jspolsky/blinky/blinky (esp32-idf)/README.md

# blinky by Joel

The code that runs the 2022 burning man BLINKY gift.

Intended for ESP32-C3 chips, using native Espressif stuff (IDF) without any Arduino code.

Best run/built/edited using VS Code.
