jspolsky/blinky/pcbs/turtleEdge/Bitmap All Outline Only.png

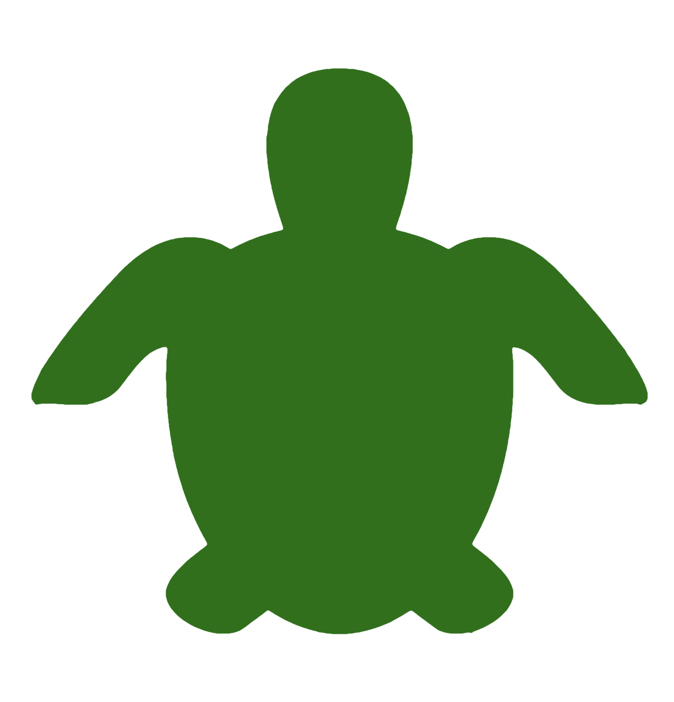
pcbs/turtleEdge/Bitmap All Outline Only.png
