jspolsky/blinky/pcbs/turtleEdge/Bitmap All.pxd/QuickLook/Thumbnail.tiff

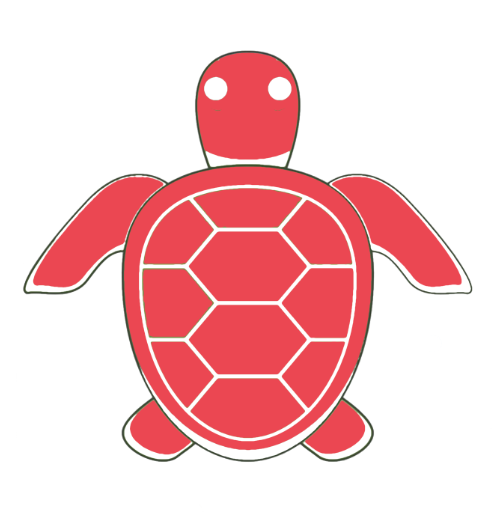
pcbs/turtleEdge/Bitmap All.pxd/QuickLook/Thumbnail.tiff
