jspolsky/blinky/pcbs/turtleEdge/OriginalScreenShot.png

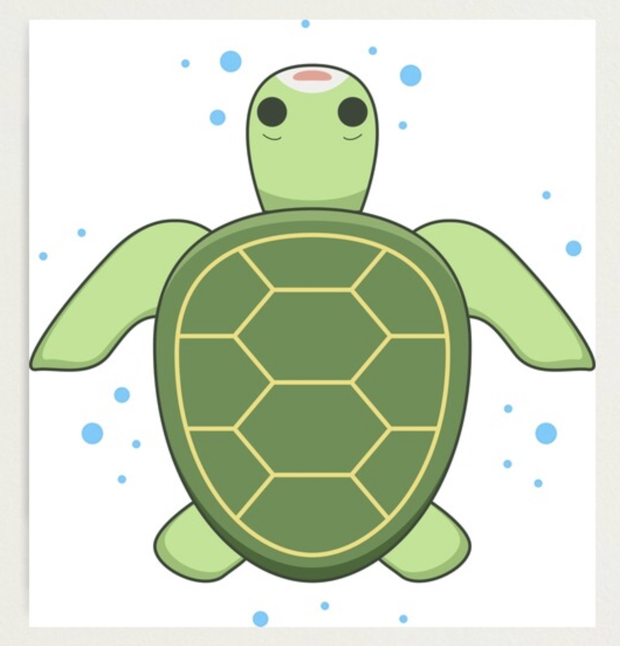
pcbs/turtleEdge/OriginalScreenShot.png
