jspolsky/blinky/pcbs/ledtrix/ledtrix_gerber_01/bom.xlsx

Comment | Designator | Footprint | LCSC Part Number
White 0603 Light Emitting Diodes (LED) RoHS | D1.1, D1.2, D1.3, D1.4, D1.5, D1.6, D1.7, D1.8, D1.9, D1.10, D1.11, D1.12, D1.13, D1.14, D1.15, D1.16 | 0603 | C2290
White 0603 Light Emitting Diodes (LED) RoHS | D2.1, D2.2, D2.3, D2.4, D2.5, D2.6, D2.7, D2.8, D2.9, D2.10, D2.11, D2.12, D2.13, D2.14, D2.15, D2.16 | 0603 | C2290
White 0603 Light Emitting Diodes (LED) RoHS | D3.1, D3.2, D3.3, D3.4, D3.5, D3.6, D3.7, D3.8, D3.9, D3.10, D3.11, D3.12, D3.13, D3.14, D3.15, D3.16 | 0603 | C2290
White 0603 Light Emitting Diodes (LED) RoHS | D4.1, D4.2, D4.3, D4.4, D4.5, D4.6, D4.7, D4.8, D4.9, D4.10, D4.11, D4.12, D4.13, D4.14, D4.15, D4.16 | 0603 | C2290
White 0603 Light Emitting Diodes (LED) RoHS | D5.1, D5.2, D5.3, D5.4, D5.5, D5.6, D5.7, D5.8, D5.9, D5.10, D5.11, D5.12, D5.13, D5.14, D5.15, D5.16 | 0603 | C2290
White 0603 Light Emitting Diodes (LED) RoHS | D6.1, D6.2, D6.3, D6.4, D6.5, D6.6, D6.7, D6.8, D6.9, D6.10, D6.11, D6.12, D6.13, D6.14, D6.15, D6.16 | 0603 | C2290
White 0603 Light Emitting Diodes (LED) RoHS | D7.1, D7.2, D7.3, D7.4, D7.5, D7.6, D7.7, D7.8, D7.9, D7.10, D7.11, D7.12, D7.13, D7.14, D7.15, D7.16 | 0603 | C2290
White 0603 Light Emitting Diodes (LED) RoHS | D8.1, D8.2, D8.3, D8.4, D8.5, D8.6, D8.7, D8.8, D8.9, D8.10, D8.11, D8.12, D8.13, D8.14, D8.15, D8.16 | 0603 | C2290
White 0603 Light Emitting Diodes (LED) RoHS | D9.1, D9.2, D9.3, D9.4, D9.5, D9.6, D9.7, D9.8, D9.9, D9.10, D9.11, D9.12, D9.13, D9.14, D9.15, D9.16 | 0603 | C2290
