jspolsky/blinky/pcbs/turtleEdge/R14_Outline.dxf

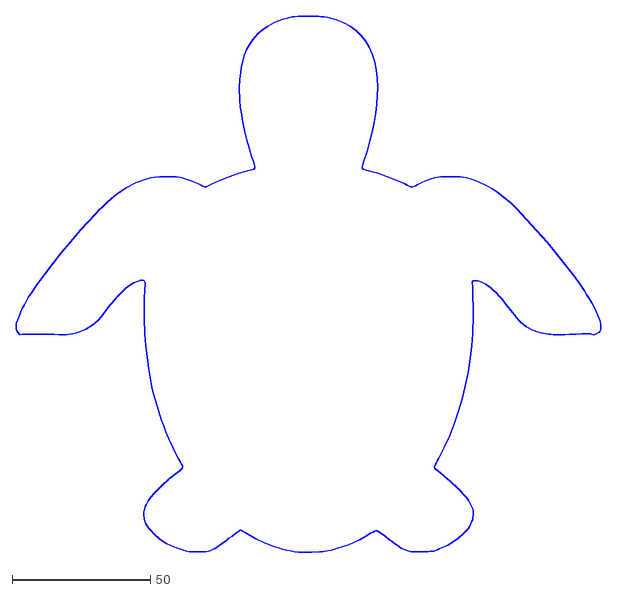
[picture p4: CAD file, 2021-12-18]
pcbs/turtleEdge/R14_Outline.dxf
211.7 x 194.2
