jspolsky/blinky/pcbShape/piece1.dxf

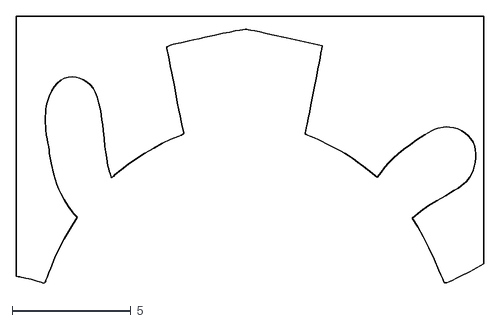
[picture p5: CAD file, 2021-12-30]
pcbShape/piece1.dxf
19.7 x 11.3
