jspolsky/blinky/pcbShape/piece1-4.dxf

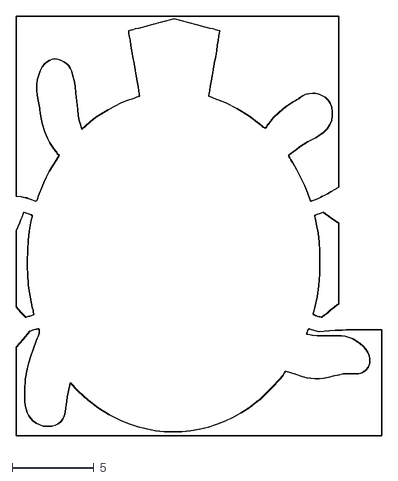
[picture p6: CAD file, 2021-12-30]
pcbShape/piece1-4.dxf
22.4 x 26.0
