jspolsky/blinky/pcbShape/experiment.dxf

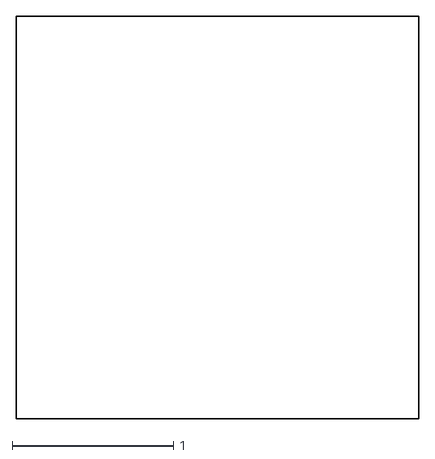
[picture p7: CAD file, 2021-12-30]
pcbShape/experiment.dxf
2.50 x 2.50
