jspolsky/blinky/pcbShape/turtle.dxf

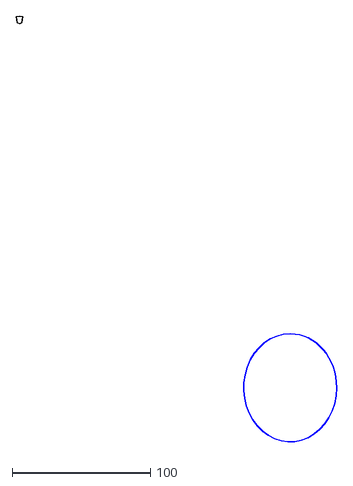
[picture p8: CAD file, 2021-12-30]
pcbShape/turtle.dxf
232.1 x 311.4
