jspolsky/blinky/pcbs/blinky/blinky.kicad_pcb

## KiCad design pcbs/blinky/blinky.kicad_pcb (2022-02-21)

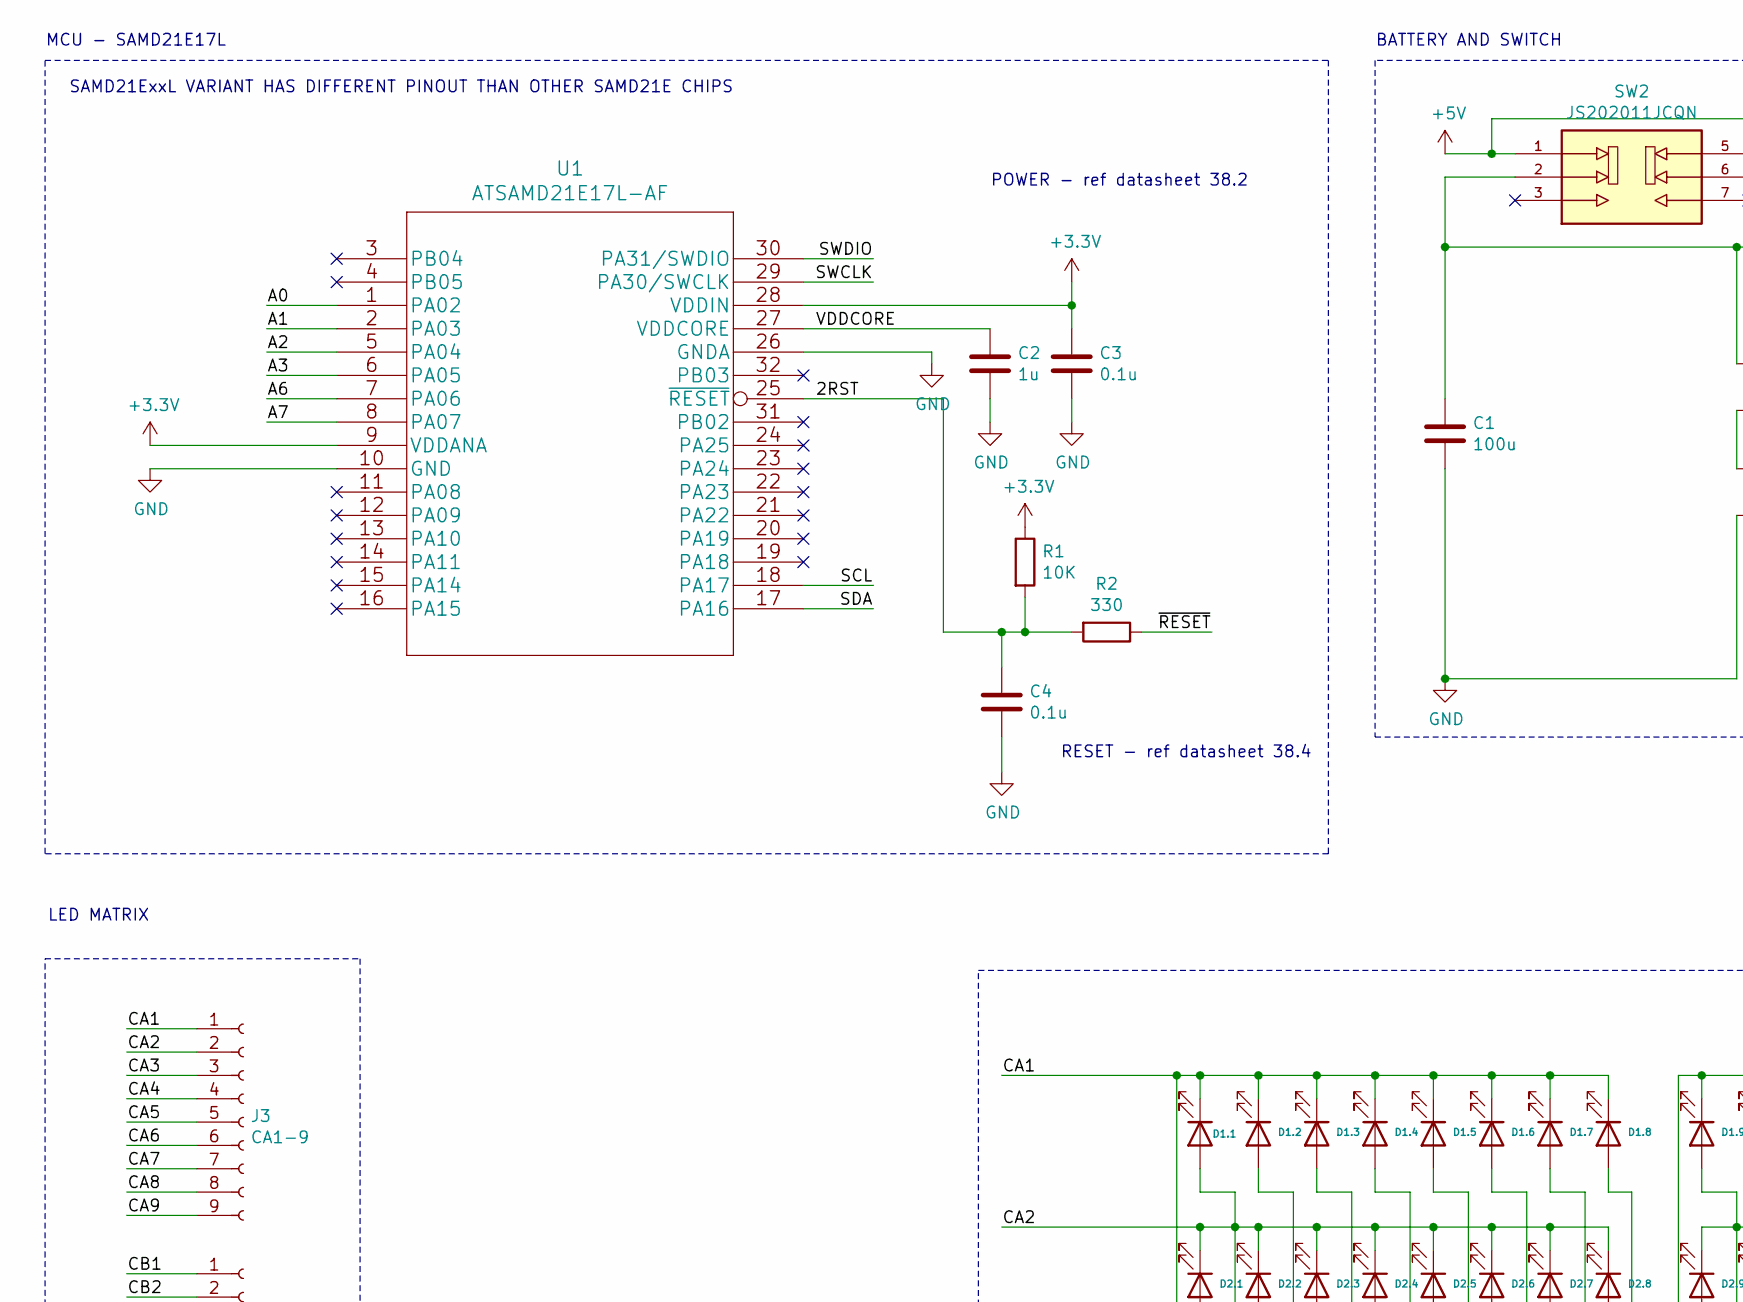
[picture p9: schematic blinky.sch, part in row 1, column 1]

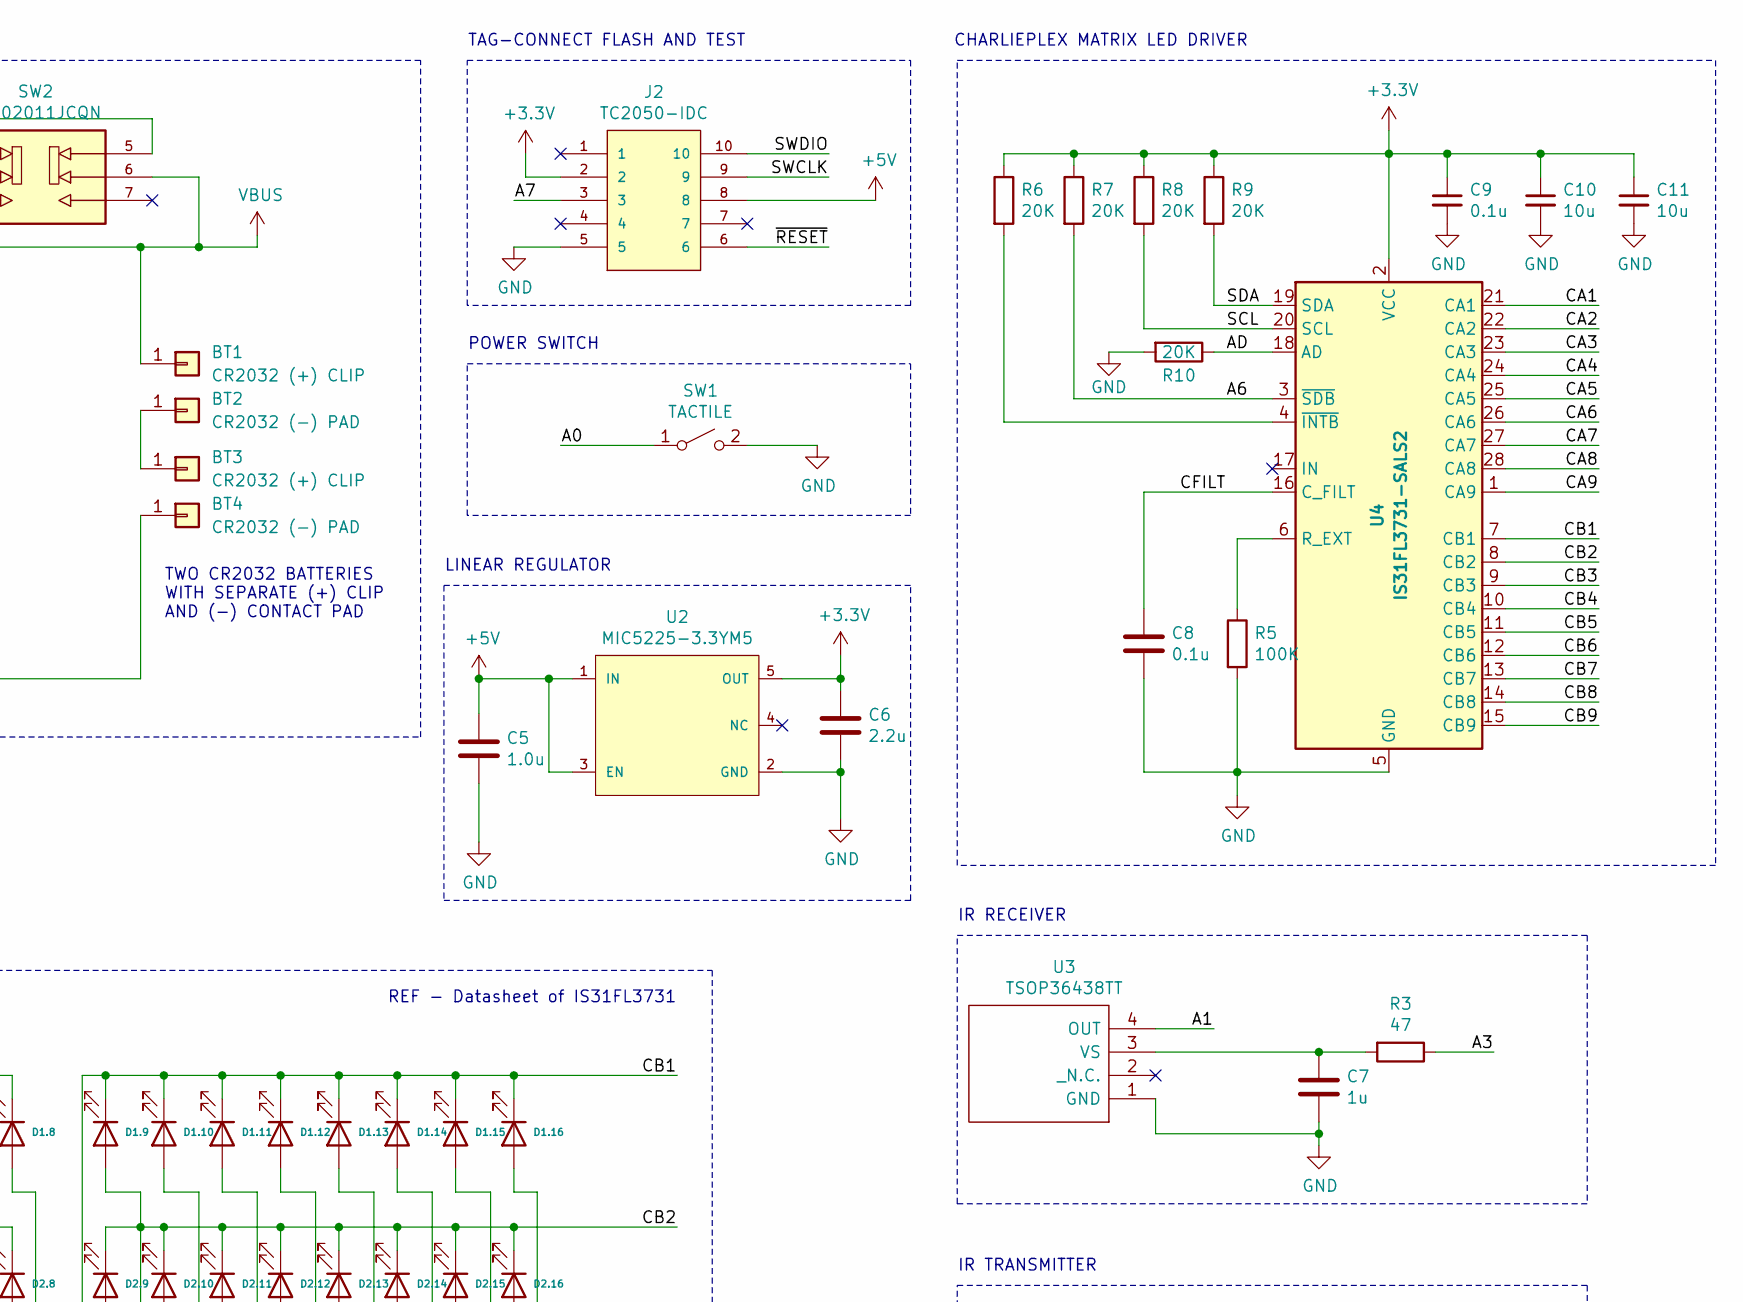
[picture p10: schematic blinky.sch, part in row 1, column 2]

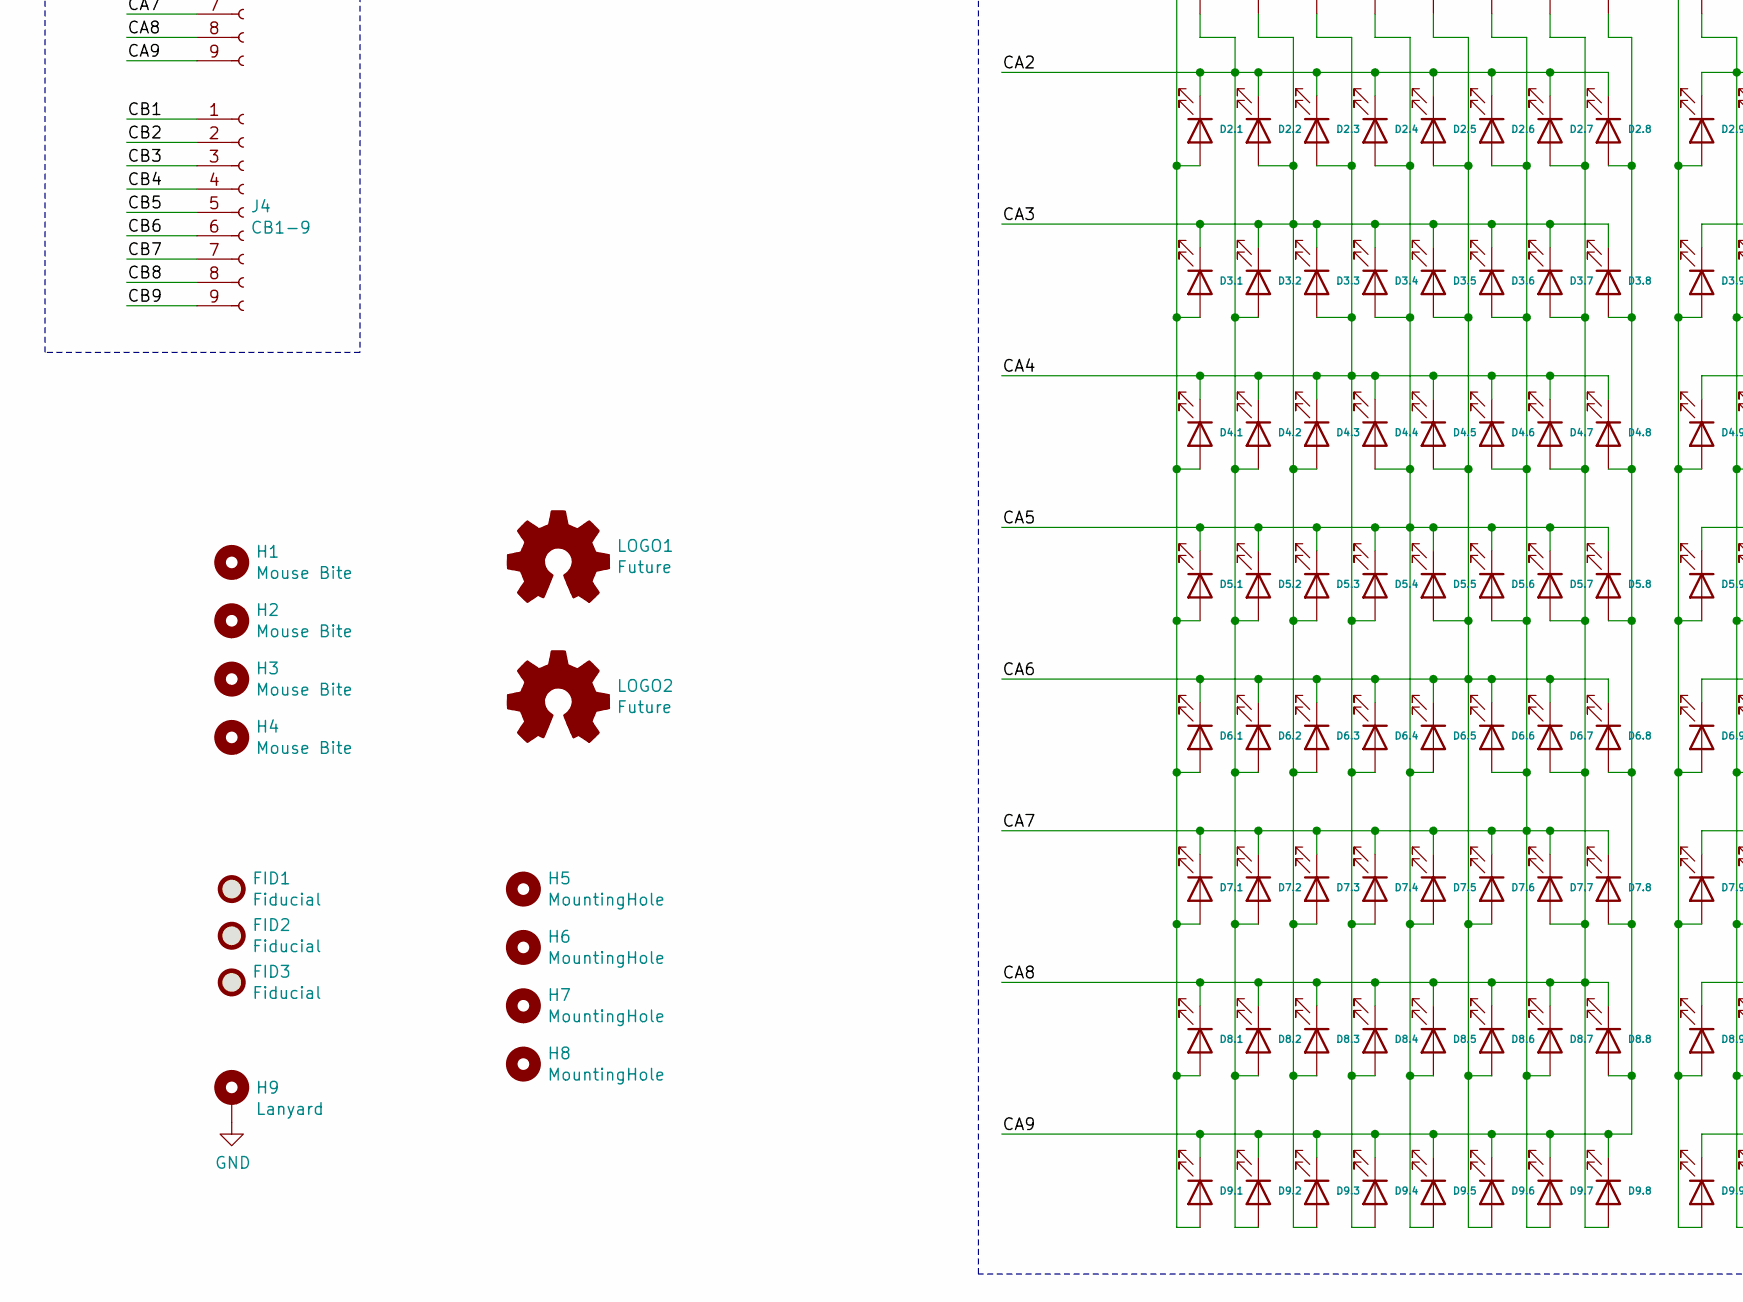
[picture p11: schematic blinky.sch, part in row 2, column 1]

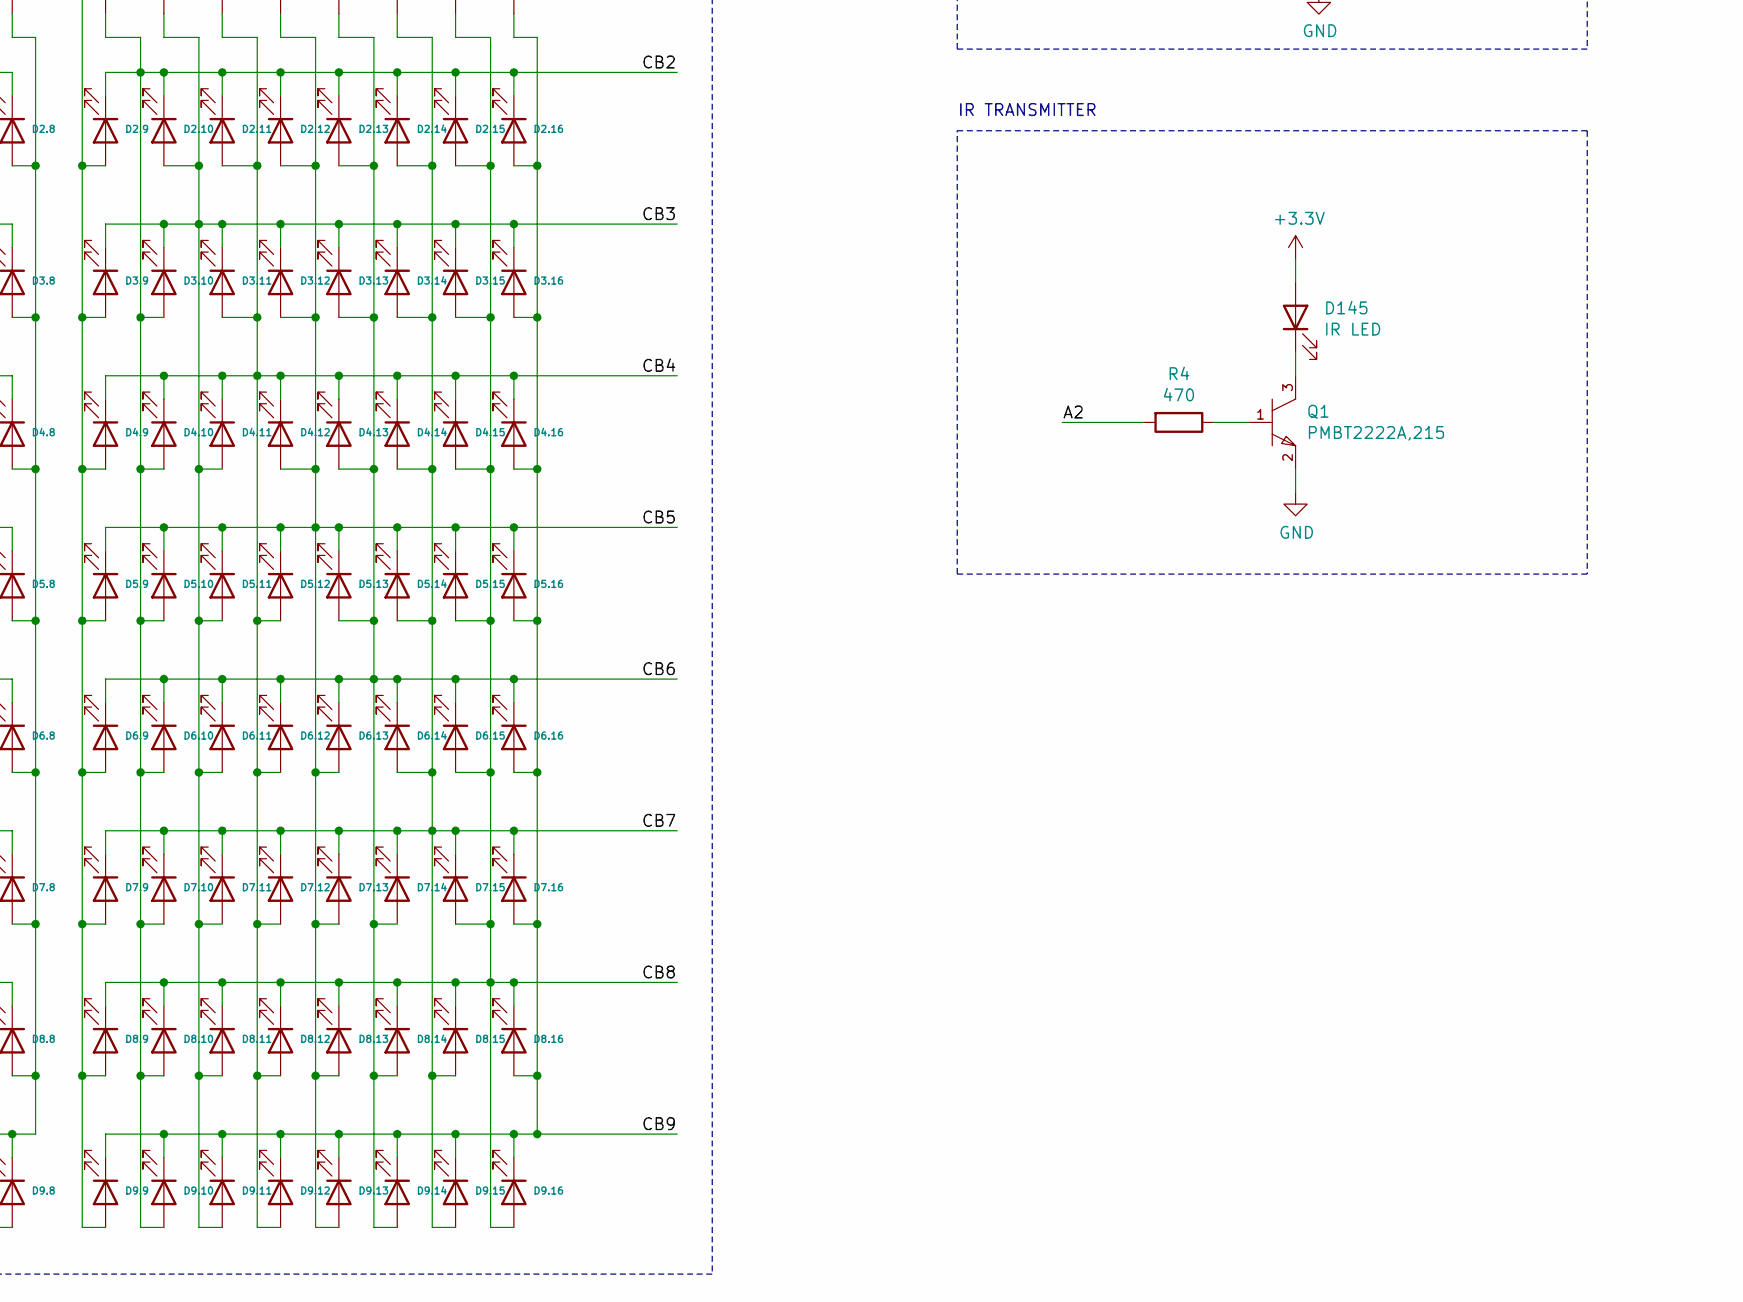
[picture p12: schematic blinky.sch, part in row 2, column 2]

Parts:
BT1, BT3: CR2032 (+) CLIP; BatteryHolder_Keystone_3034_Pos_Clip; part number 3034
BT2, BT4: CR2032 (-) PAD; Keystone_2992_Negative_Contact_Pad
C1: 100u; C_1206_3216Metric
C2, C7: 1u; C_0603_1608Metric
C3, C4, C8, C9: 0.1u; C_0603_1608Metric
C5: 1.0u; C_0603_1608Metric
C6: 2.2u; C_0603_1608Metric
C10, C11: 10u; C_0603_1608Metric
D1.1, D1.2, D1.3, D1.4, D1.5, D1.6, D1.7, D1.8, D1.9, D1.10, D1.11, D1.12, D1.13, D1.14, D1.15, D1.16, D2.1, D2.2, D2.3, D2.4, D2.5, D2.6, D2.7, D2.8, D2.9, D2.10, D2.11, D2.12, D2.13, D2.14, D2.15, D2.16, D3.1, D3.2, D3.3, D3.4, D3.5, D3.6, D3.7, D3.8, D3.9, D3.10, D3.11, D3.12, D3.13, D3.14, D3.15, D3.16, D4.1, D4.2, D4.3, D4.4, D4.5, D4.6, D4.7, D4.8, D4.9, D4.10, D4.11, D4.12, D4.13, D4.14, D4.15, D4.16, D5.1, D5.2, D5.3, D5.4, D5.5, D5.6, D5.7, D5.8, D5.9, D5.10, D5.11, D5.12, D5.13, D5.14, D5.15, D5.16, D6.1, D6.2, D6.3, D6.4, D6.5, D6.6, D6.7, D6.8, D6.9, D6.10, D6.11, D6.12, D6.13, D6.14, D6.15, D6.16, D7.1, D7.2, D7.3, D7.4, D7.5, D7.6, D7.7, D7.8, D7.9, D7.10, D7.11, D7.12, D7.13, D7.14, D7.15, D7.16, D8.1, D8.2, D8.3, D8.4, D8.5, D8.6, D8.7, D8.8, D8.9, D8.10, D8.11, D8.12, D8.13, D8.14, D8.15, D8.16, D9.1, D9.2, D9.3, D9.4, D9.5, D9.6, D9.7, D9.8, D9.9, D9.10, D9.11, D9.12, D9.13, D9.14, D9.15, D9.16: LED; LED_0603_For_Blinky
D145: IR LED; LED_0805_2012Metric; part number APT2012F3C
FID1, FID2, FID3: Fiducial; Fiducial_1mm_Mask3mm
H1, H2, H3, H4: Mouse Bite; Mouse_Bite_For_Clipper
H5, H6, H7, H8: MountingHole; JCLPCB_Tooling_Hole
H9: Lanyard; MountingHole_2.5mm_Pad_Via
J2: TC2050-IDC; TAG-CONNECT_TC2050-IDC; PARTREV A
J3: CA1-9; PinHeader_1x09_P2.54mm_Vertical
J4: CB1-9; PinHeader_1x09_P2.54mm_Vertical
LOGO1: Future; logo-future
LOGO2: Future; logo-turtles
Q1: PMBT2222A,215; NXP-TO-236AB-0-0-0; mouser part number 771-PMBT2222A-T/R; digikey description TRANS NPN 40V 0.6A SOT23
R1: 10K; R_0603_1608Metric
R2: 330; R_0603_1608Metric
R3: 47; R_0603_1608Metric
R4: 470; R_0603_1608Metric
R5: 100K; R_0603_1608Metric
R6, R7, R8, R9, R10: 20K; R_0603_1608Metric
SW1: TACTILE; TL9320AF400QG; part number TL9320AF 400QG
SW2: JS202011JCQN; CK-JS202011JCQN; PARTREV 11 Nov 19
U1: ATSAMD21E17L-AF; ATSAMD21E17_32Pin_TQFP
U2: MIC5225-3.3YM5; MIC5225-SOT23-5LD; dropout voltage 310mV; output voltage 3.3V; mouser part number 998-MIC5225-3.3YM5TR; digikey description IC REG LINEAR 3.3V 150MA SOT23-5
U3: TSOP36438TT; Manufacturer_Part_Number TSOP36438TT; Mouser Part Number 78-TSOP36438TT
U4: IS31FL3731-SALS2; SSOP-28_5.3x10.2mm_P0.65mm; part number IS31FL3731-SALS2

Connections:
+3V3: C3.1, C6.1, C9.1, C10.1, C11.1, D145.2 (A), J2.2, R1.1, R6.1, R7.1, R8.1, R9.1, U1.9 (VDDANA), U1.28 (VDDIN), U2.5 (OUT), U4.2 (VCC)
+5V: C5.1, J2.8, SW2.1, SW2.5, U2.1 (IN), U2.3 (EN)
/2RST: C4.1, R1.2, R2.2, U1.25 (~RESET)
/A0: SW1.1 (A), U1.1 (PA02)
/A1: U1.2 (PA03), U3.4 (OUT)
/A2: R4.2, U1.5 (PA04)
/A3: R3.1, U1.6 (PA05)
/A6: R7.2, U1.7 (PA06), U4.3 (~SDB)
/A7: J2.3, U1.8 (PA07)
/AD: R10.1, U4.18 (AD)
/CA1: D1.1.1 (K), D1.2.1 (K), D1.3.1 (K), D1.4.1 (K), D1.5.1 (K), D1.6.1 (K), D1.7.1 (K), D1.8.1 (K), D2.1.2 (A), D3.1.2 (A), D4.1.2 (A), D5.1.2 (A), D6.1.2 (A), D7.1.2 (A), D8.1.2 (A), D9.1.2 (A), J3.1, U4.21 (CA1)
/CA2: D1.1.2 (A), D2.1.1 (K), D2.2.1 (K), D2.3.1 (K), D2.4.1 (K), D2.5.1 (K), D2.6.1 (K), D2.7.1 (K), D2.8.1 (K), D3.2.2 (A), D4.2.2 (A), D5.2.2 (A), D6.2.2 (A), D7.2.2 (A), D8.2.2 (A), D9.2.2 (A), J3.2, U4.22 (CA2)
/CA3: D1.2.2 (A), D2.2.2 (A), D3.1.1 (K), D3.2.1 (K), D3.3.1 (K), D3.4.1 (K), D3.5.1 (K), D3.6.1 (K), D3.7.1 (K), D3.8.1 (K), D4.3.2 (A), D5.3.2 (A), D6.3.2 (A), D7.3.2 (A), D8.3.2 (A), D9.3.2 (A), J3.3, U4.23 (CA3)
/CA4: D1.3.2 (A), D2.3.2 (A), D3.3.2 (A), D4.1.1 (K), D4.2.1 (K), D4.3.1 (K), D4.4.1 (K), D4.5.1 (K), D4.6.1 (K), D4.7.1 (K), D4.8.1 (K), D5.4.2 (A), D6.4.2 (A), D7.4.2 (A), D8.4.2 (A), D9.4.2 (A), J3.4, U4.24 (CA4)
/CA5: D1.4.2 (A), D2.4.2 (A), D3.4.2 (A), D4.4.2 (A), D5.1.1 (K), D5.2.1 (K), D5.3.1 (K), D5.4.1 (K), D5.5.1 (K), D5.6.1 (K), D5.7.1 (K), D5.8.1 (K), D6.5.2 (A), D7.5.2 (A), D8.5.2 (A), D9.5.2 (A), J3.5, U4.25 (CA5)
/CA6: D1.5.2 (A), D2.5.2 (A), D3.5.2 (A), D4.5.2 (A), D5.5.2 (A), D6.1.1 (K), D6.2.1 (K), D6.3.1 (K), D6.4.1 (K), D6.5.1 (K), D6.6.1 (K), D6.7.1 (K), D6.8.1 (K), D7.6.2 (A), D8.6.2 (A), D9.6.2 (A), J3.6, U4.26 (CA6)
/CA7: D1.6.2 (A), D2.6.2 (A), D3.6.2 (A), D4.6.2 (A), D5.6.2 (A), D6.6.2 (A), D7.1.1 (K), D7.2.1 (K), D7.3.1 (K), D7.4.1 (K), D7.5.1 (K), D7.6.1 (K), D7.7.1 (K), D7.8.1 (K), D8.7.2 (A), D9.7.2 (A), J3.7, U4.27 (CA7)
/CA8: D1.7.2 (A), D2.7.2 (A), D3.7.2 (A), D4.7.2 (A), D5.7.2 (A), D6.7.2 (A), D7.7.2 (A), D8.1.1 (K), D8.2.1 (K), D8.3.1 (K), D8.4.1 (K), D8.5.1 (K), D8.6.1 (K), D8.7.1 (K), D8.8.1 (K), D9.8.2 (A), J3.8, U4.28 (CA8)
/CA9: D1.8.2 (A), D2.8.2 (A), D3.8.2 (A), D4.8.2 (A), D5.8.2 (A), D6.8.2 (A), D7.8.2 (A), D8.8.2 (A), D9.1.1 (K), D9.2.1 (K), D9.3.1 (K), D9.4.1 (K), D9.5.1 (K), D9.6.1 (K), D9.7.1 (K), D9.8.1 (K), J3.9, U4.1 (CA9)
/CB1: D1.9.1 (K), D1.10.1 (K), D1.11.1 (K), D1.12.1 (K), D1.13.1 (K), D1.14.1 (K), D1.15.1 (K), D1.16.1 (K), D2.9.2 (A), D3.9.2 (A), D4.9.2 (A), D5.9.2 (A), D6.9.2 (A), D7.9.2 (A), D8.9.2 (A), D9.9.2 (A), J4.1, U4.7 (CB1)
/CB2: D1.9.2 (A), D2.9.1 (K), D2.10.1 (K), D2.11.1 (K), D2.12.1 (K), D2.13.1 (K), D2.14.1 (K), D2.15.1 (K), D2.16.1 (K), D3.10.2 (A), D4.10.2 (A), D5.10.2 (A), D6.10.2 (A), D7.10.2 (A), D8.10.2 (A), D9.10.2 (A), J4.2, U4.8 (CB2)
/CB3: D1.10.2 (A), D2.10.2 (A), D3.9.1 (K), D3.10.1 (K), D3.11.1 (K), D3.12.1 (K), D3.13.1 (K), D3.14.1 (K), D3.15.1 (K), D3.16.1 (K), D4.11.2 (A), D5.11.2 (A), D6.11.2 (A), D7.11.2 (A), D8.11.2 (A), D9.11.2 (A), J4.3, U4.9 (CB3)
/CB4: D1.11.2 (A), D2.11.2 (A), D3.11.2 (A), D4.9.1 (K), D4.10.1 (K), D4.11.1 (K), D4.12.1 (K), D4.13.1 (K), D4.14.1 (K), D4.15.1 (K), D4.16.1 (K), D5.12.2 (A), D6.12.2 (A), D7.12.2 (A), D8.12.2 (A), D9.12.2 (A), J4.4, U4.10 (CB4)
/CB5: D1.12.2 (A), D2.12.2 (A), D3.12.2 (A), D4.12.2 (A), D5.9.1 (K), D5.10.1 (K), D5.11.1 (K), D5.12.1 (K), D5.13.1 (K), D5.14.1 (K), D5.15.1 (K), D5.16.1 (K), D6.13.2 (A), D7.13.2 (A), D8.13.2 (A), D9.13.2 (A), J4.5, U4.11 (CB5)
/CB6: D1.13.2 (A), D2.13.2 (A), D3.13.2 (A), D4.13.2 (A), D5.13.2 (A), D6.9.1 (K), D6.10.1 (K), D6.11.1 (K), D6.12.1 (K), D6.13.1 (K), D6.14.1 (K), D6.15.1 (K), D6.16.1 (K), D7.14.2 (A), D8.14.2 (A), D9.14.2 (A), J4.6, U4.12 (CB6)
/CB7: D1.14.2 (A), D2.14.2 (A), D3.14.2 (A), D4.14.2 (A), D5.14.2 (A), D6.14.2 (A), D7.9.1 (K), D7.10.1 (K), D7.11.1 (K), D7.12.1 (K), D7.13.1 (K), D7.14.1 (K), D7.15.1 (K), D7.16.1 (K), D8.15.2 (A), D9.15.2 (A), J4.7, U4.13 (CB7)
/CB8: D1.15.2 (A), D2.15.2 (A), D3.15.2 (A), D4.15.2 (A), D5.15.2 (A), D6.15.2 (A), D7.15.2 (A), D8.9.1 (K), D8.10.1 (K), D8.11.1 (K), D8.12.1 (K), D8.13.1 (K), D8.14.1 (K), D8.15.1 (K), D8.16.1 (K), D9.16.2 (A), J4.8, U4.14 (CB8)
/CB9: D1.16.2 (A), D2.16.2 (A), D3.16.2 (A), D4.16.2 (A), D5.16.2 (A), D6.16.2 (A), D7.16.2 (A), D8.16.2 (A), D9.9.1 (K), D9.10.1 (K), D9.11.1 (K), D9.12.1 (K), D9.13.1 (K), D9.14.1 (K), D9.15.1 (K), D9.16.1 (K), J4.9, U4.15 (CB9)
/CFILT: C8.1, U4.16 (C_FILT)
/SCL: R8.2, U1.18 (PA17), U4.20 (SCL)
/SDA: R9.2, U1.17 (PA16), U4.19 (SDA)
/SWCLK: J2.9, U1.29 (PA30/SWCLK)
/SWDIO: J2.10, U1.30 (PA31/SWDIO)
/VDDCORE: C2.1, U1.27 (VDDCORE)
/~RESET: J2.6, R2.1
GND: BT4.1, C1.2, C2.2, C3.2, C4.2, C5.2, C6.2, C7.2, C8.2, C9.2, C10.2, C11.2, H9.1, J2.5, Q1.2 (emitter), R5.2, R10.2, SW1.2 (B), U1.10 (GND), U1.26 (GNDA), U2.2 (GND), U3.1 (GND), U4.5 (GND)
unnamed: BT2.1, BT3.1
unnamed: C7.1, R3.2, U3.3 (VS)
unnamed: D145.1 (K), Q1.3 (collector)
unnamed: Q1.1 (base), R4.1
unnamed: R5.1, U4.6 (R_EXT)
unnamed: R6.2, U4.4 (~INTB)
VBUS: BT1.1, C1.1, SW2.2, SW2.6

Notes on the sheet:
MCU - SAMD21E17L
RESET - ref datasheet 38.4
POWER - ref datasheet 38.2
LINEAR REGULATOR
BATTERY AND SWITCH
POWER SWITCH
CHARLIEPLEX MATRIX LED DRIVER
IR TRANSMITTER
IR RECEIVER
LED MATRIX
REF - Datasheet of IS31FL3731
SAMD21ExxL VARIANT HAS DIFFERENT PINOUT THAN OTHER SAMD21E CHIPS
TAG-CONNECT FLASH AND TEST
TWO CR2032 BATTERIES WITH SEPARATE (+) CLIP AND (-) CONTACT PAD

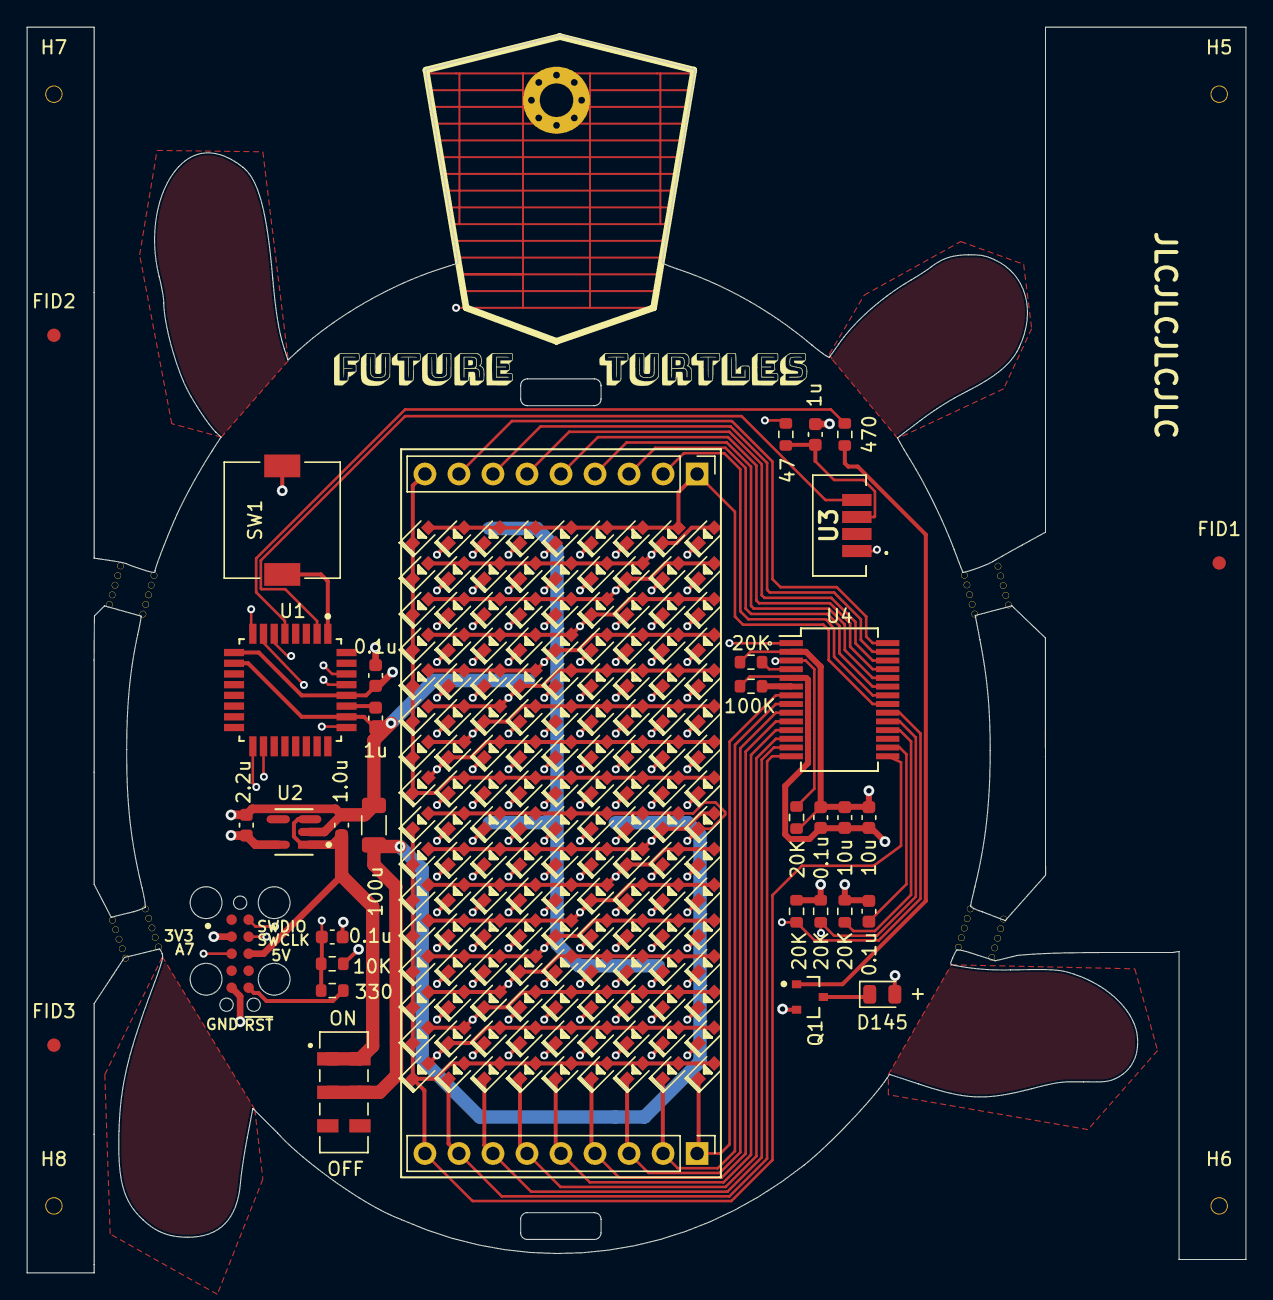
[picture p13: board blinky.kicad_pcb from above]

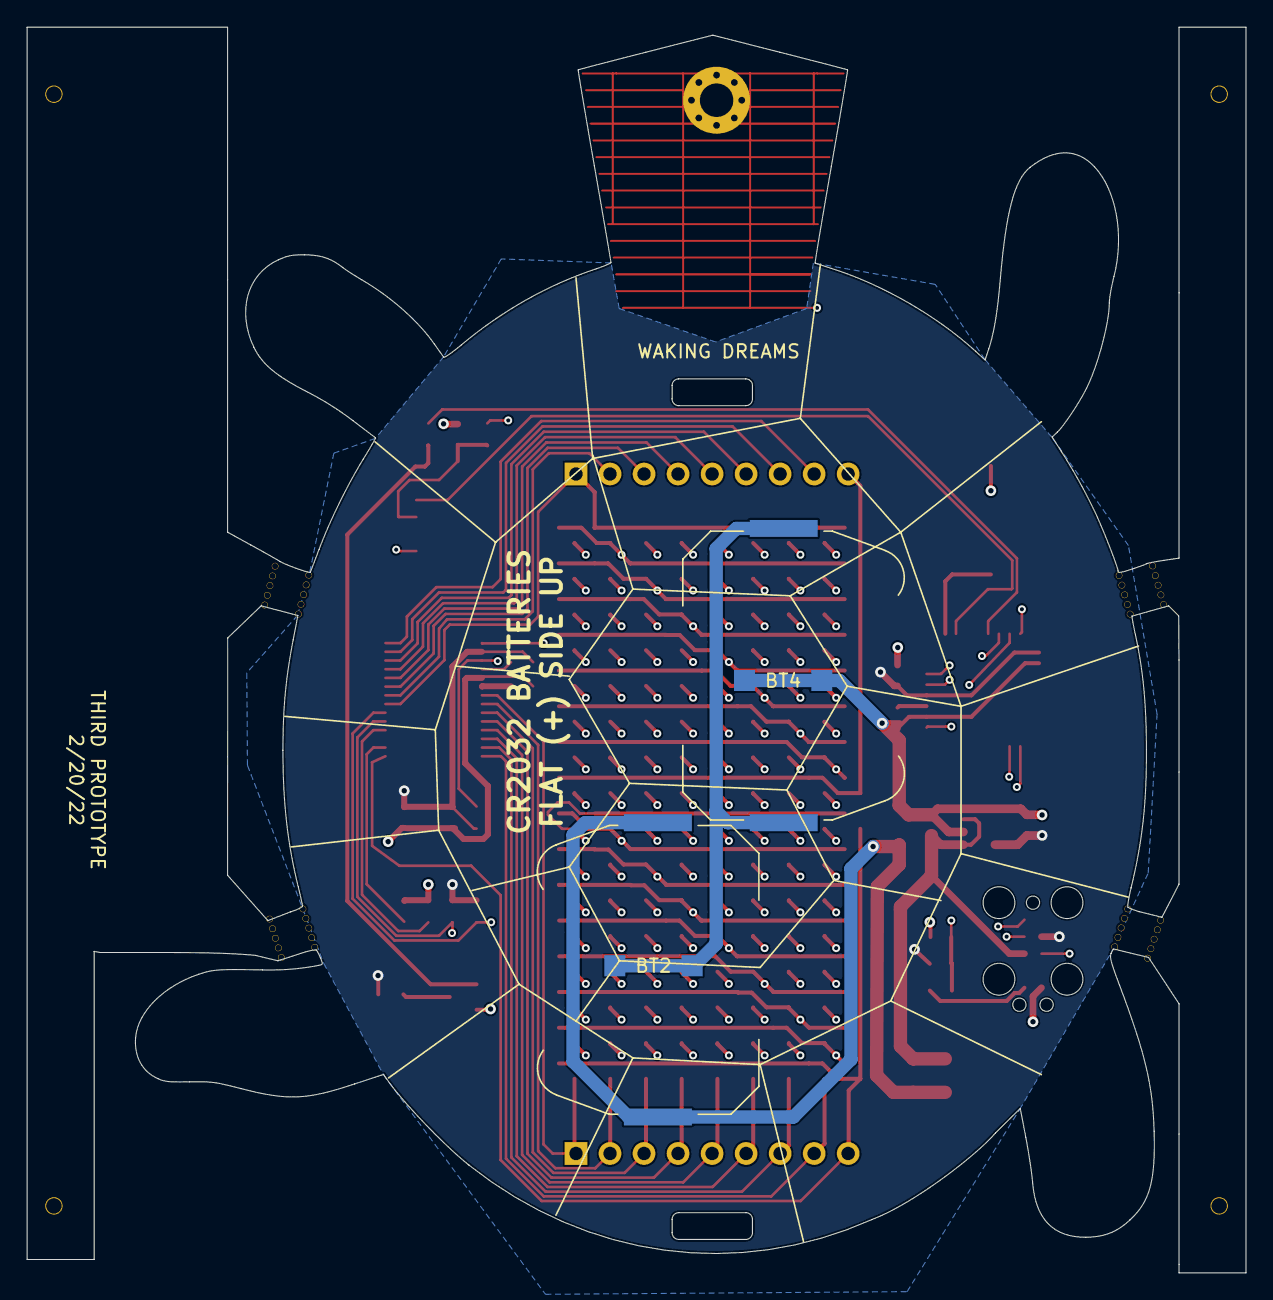
[picture p14: board blinky.kicad_pcb from below]

Board: 4 copper layers, 91.0 x 93.0 mm, 194 parts (4 on the bottom side), 43 nets.
