jspolsky/blinky/pcbs/charlieplexboard/charlieplexboard.kicad_pcb

## KiCad design pcbs/charlieplexboard/charlieplexboard.kicad_pcb (2021-12-18)

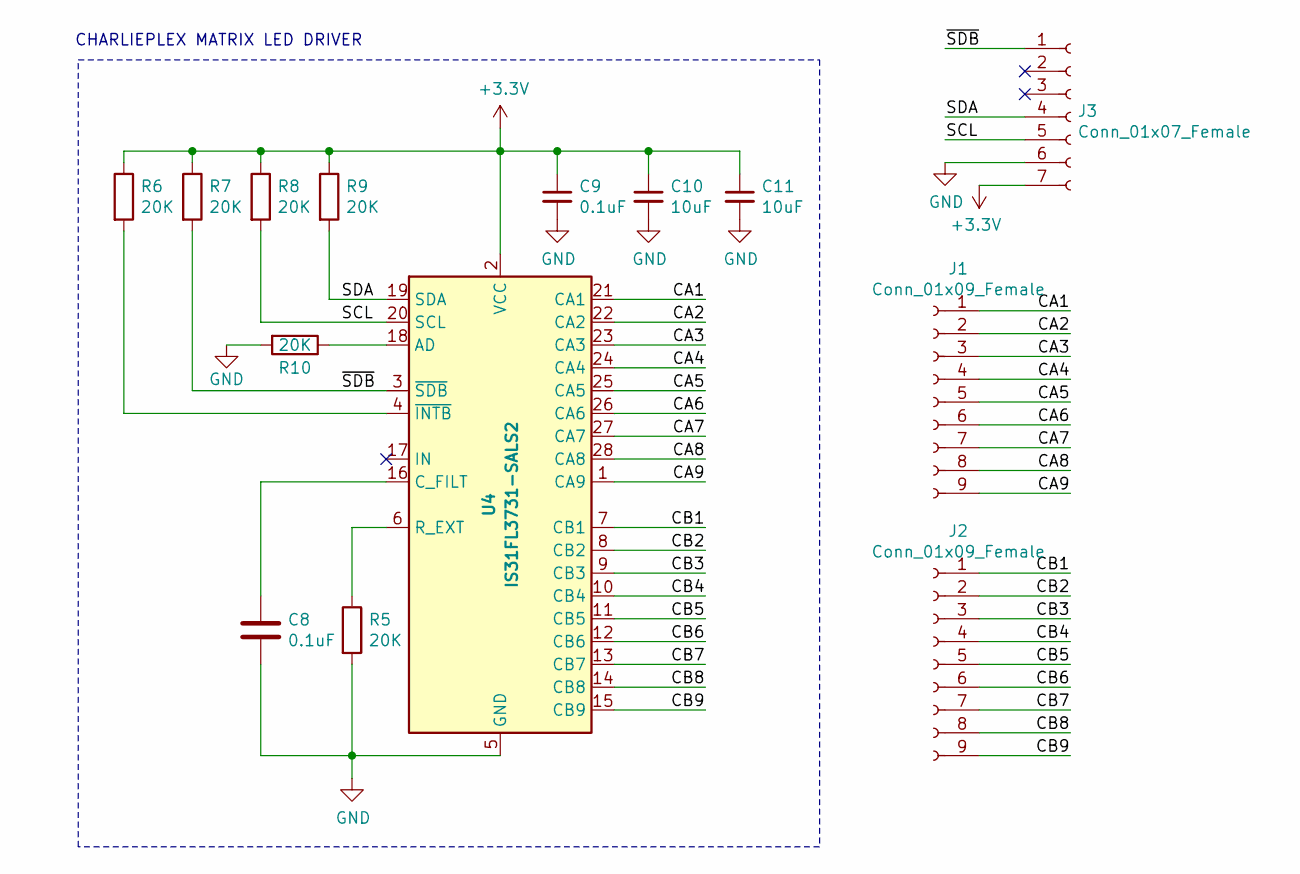
[picture p15: schematic charlieplexboard.sch]

Parts:
C8, C9: 0.1uF; C_0603_1608Metric
C10, C11: 10uF; C_0603_1608Metric
J1, J2: Conn_01x09_Female; PinSocket_1x09_P2.54mm_Vertical
J3: Conn_01x07_Female; PinHeader_1x07_P2.54mm_Vertical
R5, R6, R7, R8, R9, R10: 20K; R_0603_1608Metric
U4: IS31FL3731-SALS2; SSOP-28_5.3x10.2mm_P0.65mm; part number IS31FL3731-SALS2

Connections:
+3V3: C9.1, C10.1, C11.1, J3.7, R6.1, R7.1, R8.1, R9.1, U4.2 (VCC)
/CA1: J1.1, U4.21 (CA1)
/CA2: J1.2, U4.22 (CA2)
/CA3: J1.3, U4.23 (CA3)
/CA4: J1.4, U4.24 (CA4)
/CA5: J1.5, U4.25 (CA5)
/CA6: J1.6, U4.26 (CA6)
/CA7: J1.7, U4.27 (CA7)
/CA8: J1.8, U4.28 (CA8)
/CA9: J1.9, U4.1 (CA9)
/CB1: J2.1, U4.7 (CB1)
/CB2: J2.2, U4.8 (CB2)
/CB3: J2.3, U4.9 (CB3)
/CB4: J2.4, U4.10 (CB4)
/CB5: J2.5, U4.11 (CB5)
/CB6: J2.6, U4.12 (CB6)
/CB7: J2.7, U4.13 (CB7)
/CB8: J2.8, U4.14 (CB8)
/CB9: J2.9, U4.15 (CB9)
/SCL: J3.5, R8.2, U4.20 (SCL)
/SDA: J3.4, R9.2, U4.19 (SDA)
/~SDB: J3.1, R7.2, U4.3 (~SDB)
GND: C8.2, C9.2, C10.2, C11.2, J3.6, R5.2, R10.2, U4.5 (GND)
unnamed: C8.1, U4.16 (C_FILT)
unnamed: R5.1, U4.6 (R_EXT)
unnamed: R6.2, U4.4 (~INTB)
unnamed: R10.1, U4.18 (AD)

Notes on the sheet:
CHARLIEPLEX MATRIX LED DRIVER

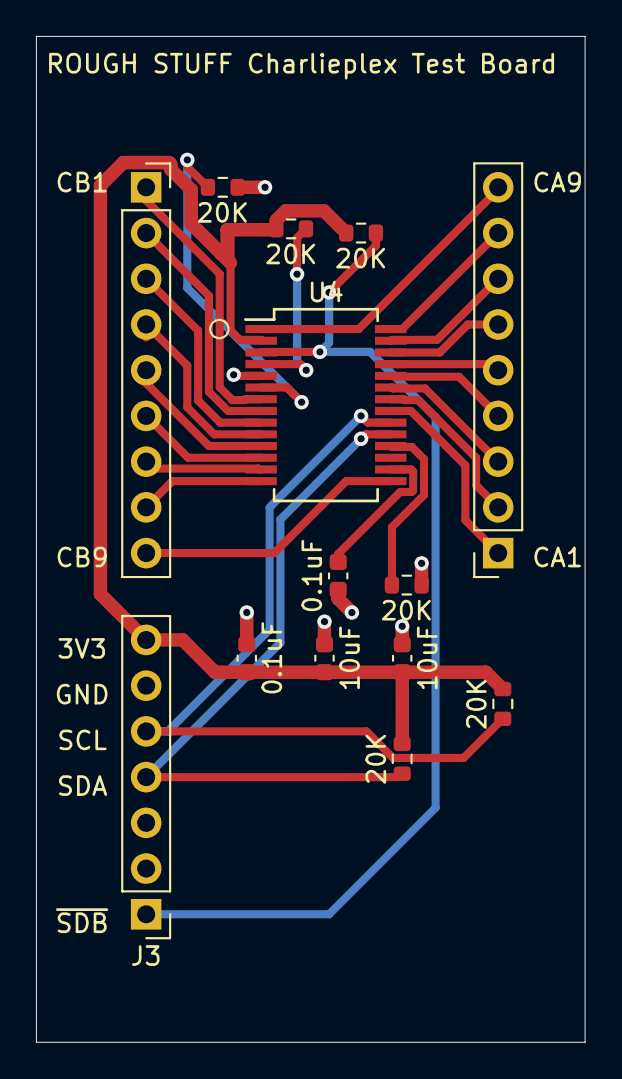
[picture p16: board charlieplexboard.kicad_pcb from above]

Board: 2 copper layers, 30.5 x 55.9 mm, 14 parts (0 on the bottom side), 27 nets.
