jspolsky/blinky/pcbs/ClonedESP32DevBoard/ClonedESP32DevBoard.kicad_pcb

## KiCad design pcbs/ClonedESP32DevBoard/ClonedESP32DevBoard.kicad_pcb (2021-12-18)

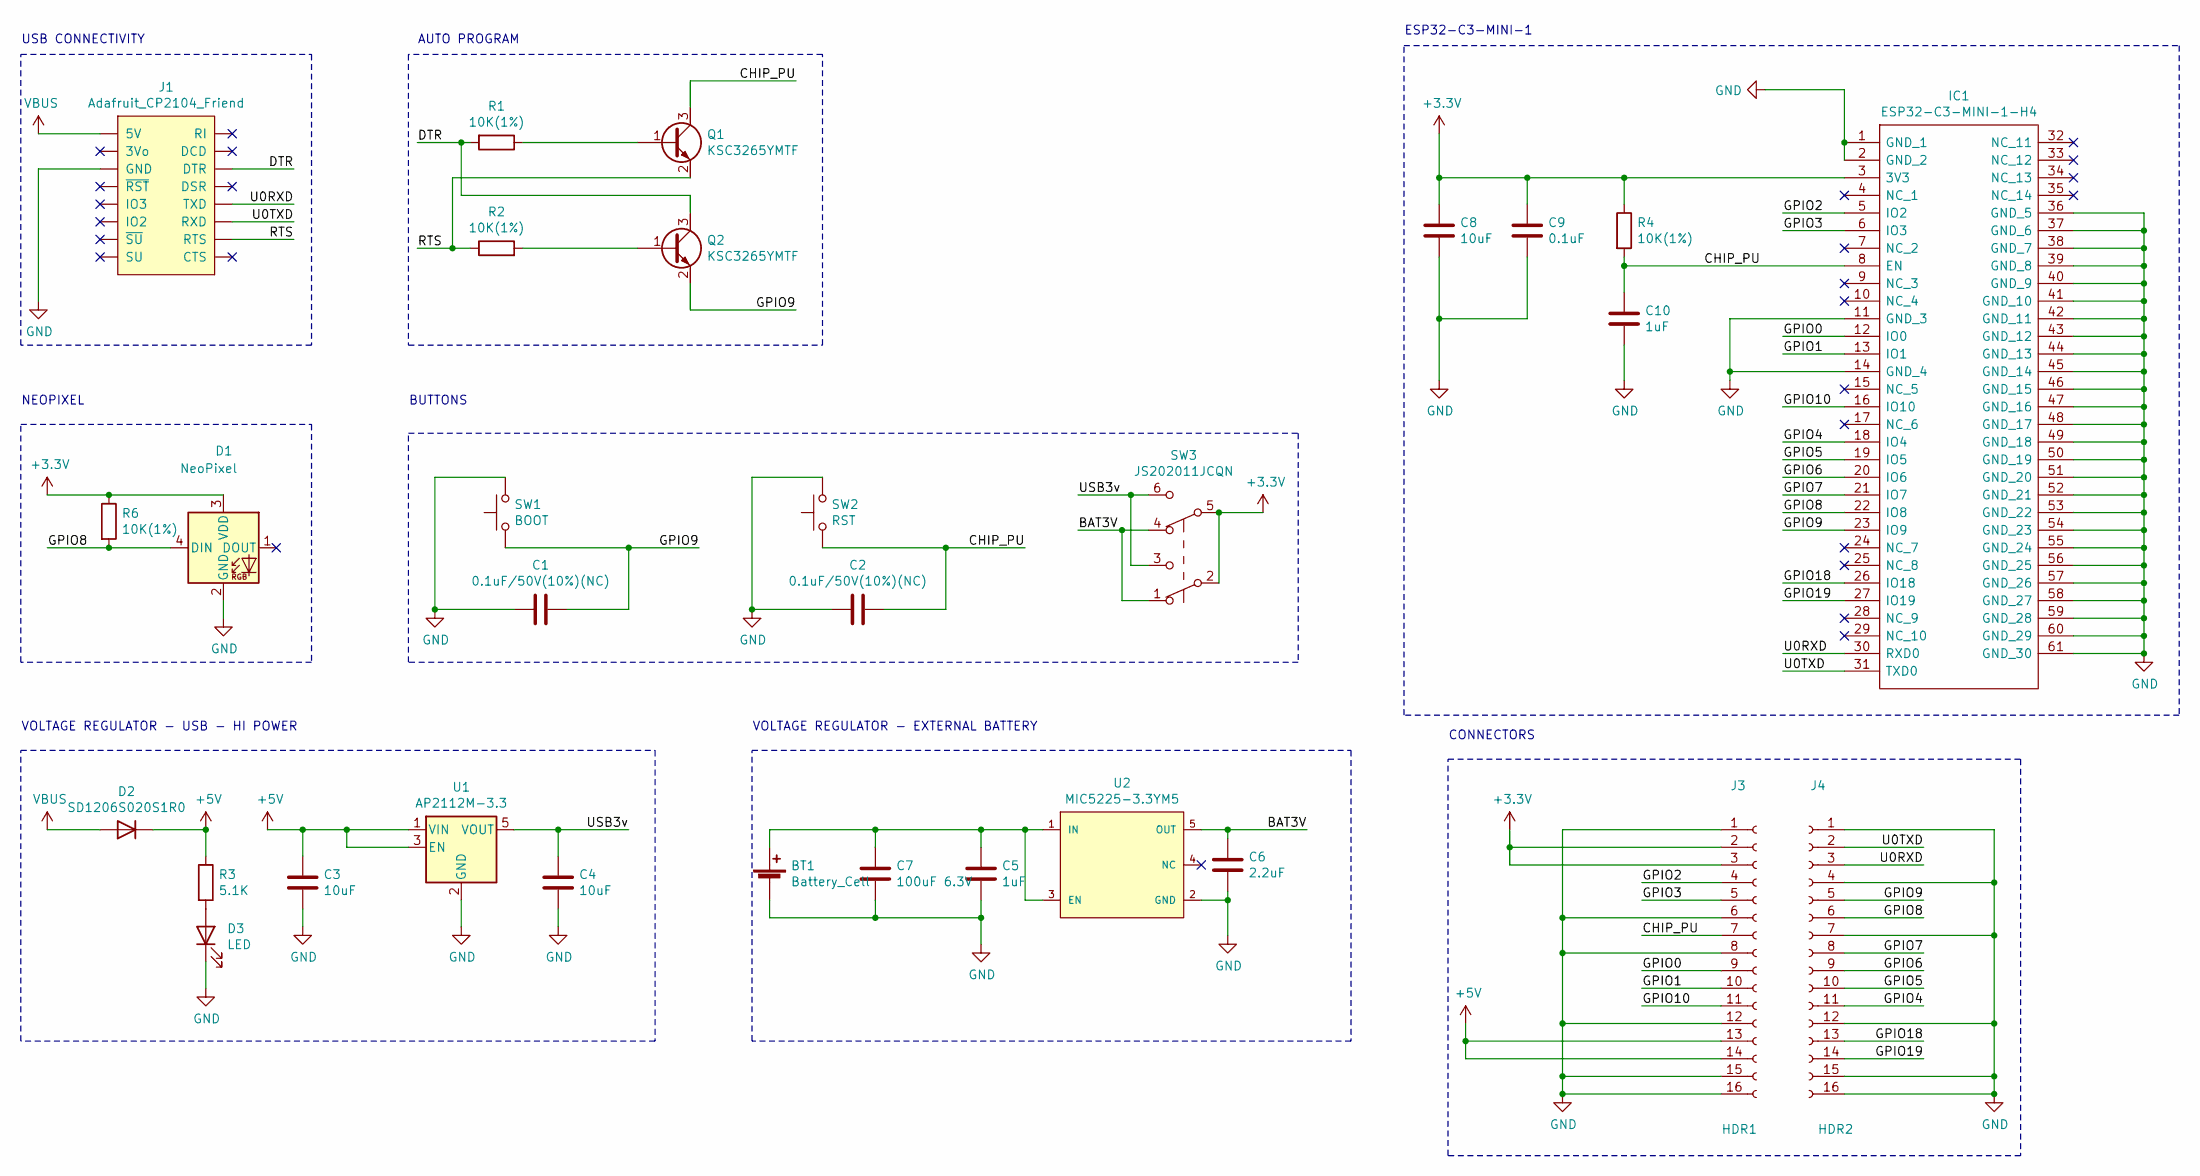
[picture p17: schematic ClonedESP32DevBoard.sch]

Parts:
BT1: Battery_Cell; PinHeader_1x02_P2.54mm_Vertical
C1, C2: 0.1uF/50V(10%)(NC); C_0805_2012Metric
C3, C4, C8: 10uF; C_0805_2012Metric
C5, C10: 1uF; C_0805_2012Metric
C6: 2.2uF; C_0805_2012Metric
C7: 100uF 6.3V; C_1210_3225Metric
C9: 0.1uF; C_0805_2012Metric
D1: NeoPixel; LED_WS2812-2020
D2: SD1206S020S1R0‎; D_1206_3216Metric
D3: LED; LED_0805_2012Metric
IC1: ESP32-C3-MINI-1-H4; ESP32-C3-MINI-1; Manufacturer_Part_Number ESP32-C3-MINI-1-H4; Mouser Part Number 356-ESP32-C3-MINI1H4
J1: Adafruit_CP2104_Friend
J3: HDR1; PinHeader_1x16_P2.54mm_Vertical
J4: HDR2; PinHeader_1x16_P2.54mm_Vertical
Q1, Q2: KSC3265YMTF; SOT-23
R1, R2, R4, R6: 10K(1%); R_0805_2012Metric
R3: 5.1K; R_0805_2012Metric
SW1: BOOT; TL9320AF400QG
SW2: RST; TL9320AF400QG
SW3: JS202011JCQN; SW_DPDT_CK_JS202011JCQN
U1: AP2112M-3.3; Diodes-SO-8
U2: MIC5225-3.3YM5; MIC5225-SOT23-5LD; dropout voltage 310mV; output voltage 3.3V; mouser part number 998-MIC5225-3.3YM5TR; digikey description IC REG LINEAR 3.3V 150MA SOT23-5

Connections:
+3V3: C8.1, C9.1, D1.3 (VDD), IC1.3 (3V3), J3.2, J3.3, R4.1, R6.1, SW3.2 (B), SW3.5 (B)
+5V: C3.1, D2.1 (K), J3.13, J3.14, R3.1, U1.1 (VIN), U1.3 (EN)
/BAT3V: C6.1, SW3.1 (A), SW3.4 (A), U2.5 (OUT)
/CHIP_PU: C2.1, C10.1, IC1.8 (EN), J3.7, Q1.3 (C), R4.2, SW2.1
/DTR: J1.14 (DTR), Q2.3 (C), R1.2
/GPIO0: IC1.12 (IO0), J3.9
/GPIO1: IC1.13 (IO1), J3.10
/GPIO2: IC1.5 (IO2), J3.4
/GPIO3: IC1.6 (IO3), J3.5
/GPIO4: IC1.18 (IO4), J4.11
/GPIO5: IC1.19 (IO5), J4.10
/GPIO6: IC1.20 (IO6), J4.9
/GPIO7: IC1.21 (IO7), J4.8
/GPIO8: D1.4 (DIN), IC1.22 (IO8), J4.6, R6.2
/GPIO9: C1.1, IC1.23 (IO9), J4.5, Q2.2 (E), SW1.1
/GPIO10: IC1.16 (IO10), J3.11
/GPIO18: IC1.26 (IO18), J4.13
/GPIO19: IC1.27 (IO19), J4.14
/RTS: J1.10 (RTS), Q1.2 (E), R2.1
/U0RXD: IC1.30 (RXD0), J1.12 (TXD), J4.3
/U0TXD: IC1.31 (TXD0), J1.11 (RXD), J4.2
/USB3v: C4.1, SW3.3 (C), SW3.6 (C), U1.5 (VOUT)
GND: BT1.2 (-), C1.2, C2.2, C3.2, C4.2, C5.2, C6.2, C7.2, C8.2, C9.2, C10.2, D1.2 (GND), D3.1 (K), IC1.1 (GND_1), IC1.2 (GND_2), IC1.11 (GND_3), IC1.14 (GND_4), IC1.36 (GND_5), IC1.37 (GND_6), IC1.38 (GND_7), IC1.39 (GND_8), IC1.40 (GND_9), IC1.41 (GND_10), IC1.42 (GND_11), IC1.43 (GND_12), IC1.44 (GND_13), IC1.45 (GND_14), IC1.46 (GND_15), IC1.47 (GND_16), IC1.48 (GND_17), IC1.49 (GND_18), IC1.50 (GND_19), IC1.51 (GND_20), IC1.52 (GND_21), IC1.53 (GND_22), IC1.54 (GND_23), IC1.55 (GND_24), IC1.56 (GND_25), IC1.57 (GND_26), IC1.58 (GND_27), IC1.59 (GND_28), IC1.60 (GND_29), IC1.61 (GND_30), J1.3 (GND), J3.1, J3.6, J3.8, J3.12, J3.15, J3.16, J4.1, J4.4, J4.7, J4.12, J4.15, J4.16, SW1.2, SW2.2, U1.2 (GND), U2.2 (GND)
unnamed: BT1.1 (+), C5.1, C7.1, U2.1 (IN), U2.3 (EN)
unnamed: D3.2 (A), R3.2
unnamed: Q1.1 (B), R1.1
unnamed: Q2.1 (B), R2.2
VBUS: D2.2 (A), J1.1 (5V)

Notes on the sheet:
USB CONNECTIVITY
AUTO PROGRAM
NEOPIXEL
BUTTONS
VOLTAGE REGULATOR - USB - HI POWER
VOLTAGE REGULATOR - EXTERNAL BATTERY
ESP32-C3-MINI-1
CONNECTORS

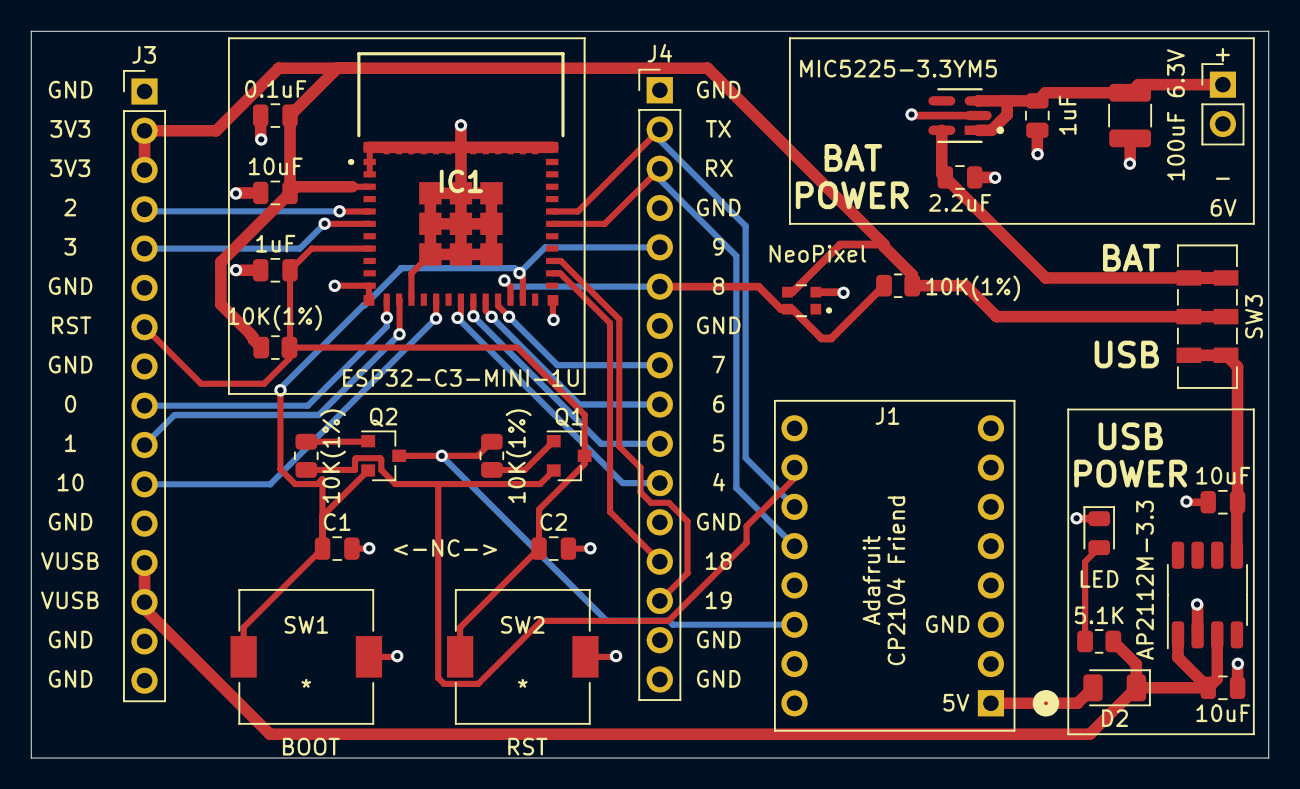
[picture p18: board ClonedESP32DevBoard.kicad_pcb from above]

Board: 2 copper layers, 80.0 x 47.0 mm, 30 parts (0 on the bottom side), 28 nets.
