jspolsky/blinky/pcbs/MinimalSAMD21/MinimalSAMD21.kicad_pcb

## KiCad design pcbs/MinimalSAMD21/MinimalSAMD21.kicad_pcb (2021-12-10)

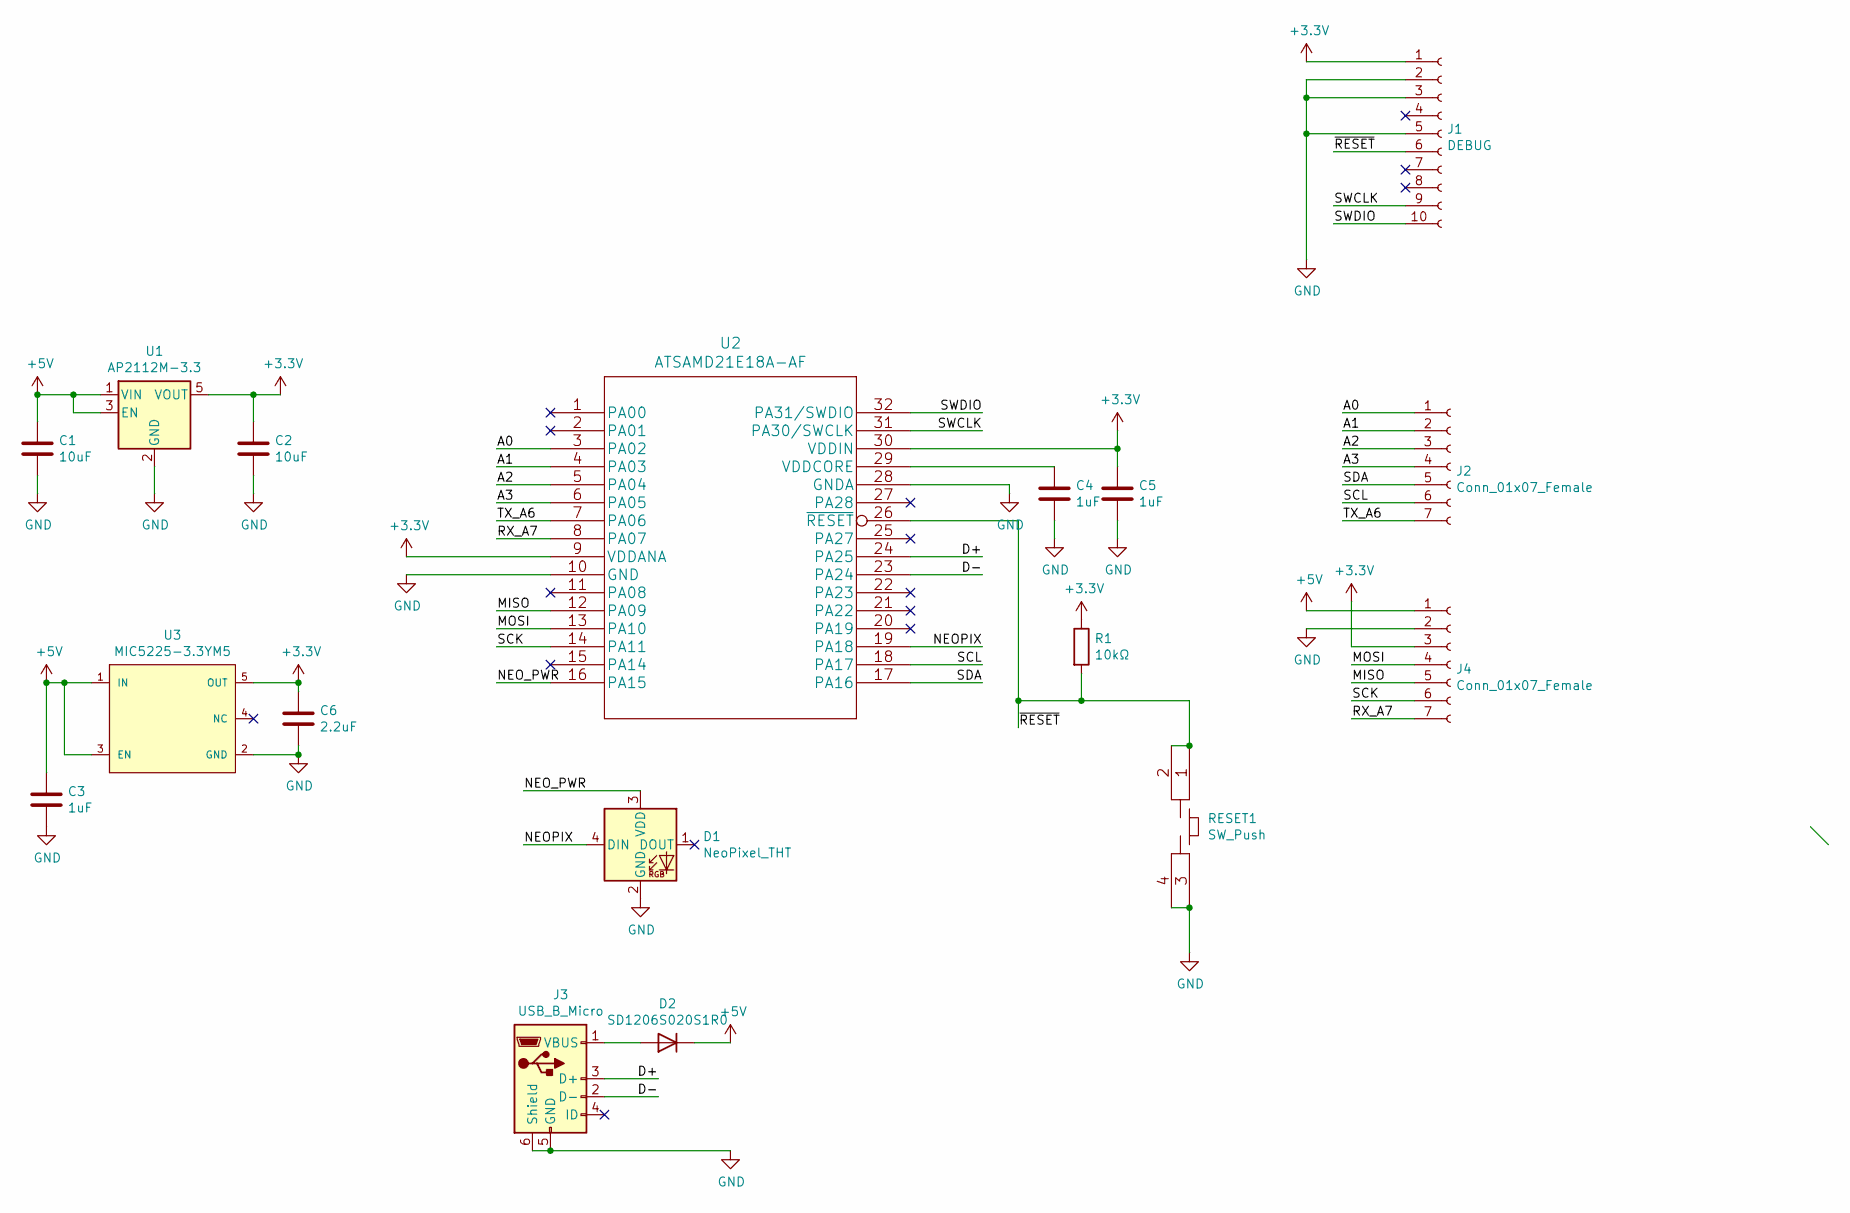
[picture p19: schematic MinimalSAMD21.sch]

Parts:
C1, C2: 10uF; C_0805_2012Metric_Pad1.18x1.45mm_HandSolder
C3, C4, C5: 1uF; C_0805_2012Metric_Pad1.18x1.45mm_HandSolder
C6: 2.2uF; C_0805_2012Metric_Pad1.18x1.45mm_HandSolder
D1: NeoPixel_THT; LED_WS2812-2020
D2: SD1206S020S1R0‎; D_1206_3216Metric
J1: DEBUG; CNC_3220-10-0300-00_SWD_Receptacle
J2, J4: Conn_01x07_Female; PinSocket_1x07_P2.54mm_Vertical
J3: USB_B_Micro; USB_Micro-B_Amphenol_10118194_Horizontal
R1: 10kΩ; R_0805_2012Metric_Pad1.20x1.40mm_HandSolder
RESET1: SW_Push; PTS526_SK15_SMTR2_LFS_Tactile_SW_5.2x5.2
U1: AP2112M-3.3; Diodes-SO-8
U2: ATSAMD21E18A-AF
U3: MIC5225-3.3YM5; MIC5225-SOT23-5LD; dropout voltage 310mV; output voltage 3.3V; mouser part number 998-MIC5225-3.3YM5TR; digikey description IC REG LINEAR 3.3V 150MA SOT23-5

Connections:
+3V3: C2.1, C5.1, C6.1, J1.1, J4.3, R1.1, U1.5 (VOUT), U2.9 (VDDANA), U2.30 (VDDIN), U3.5 (OUT); also elsewhere on the board
+5V: C1.1, C3.1, D2.1 (K), J4.1, U1.1 (VIN), U1.3 (EN), U3.1 (IN), U3.3 (EN)
/A0: J2.1, U2.3 (PA02)
/A1: J2.2, U2.4 (PA03)
/A2: J2.3, U2.5 (PA04)
/A3: J2.4, U2.6 (PA05)
/D+: J3.3 (D+), U2.24 (PA25)
/D-: J3.2 (D-), U2.23 (PA24)
/MISO: J4.5, U2.12 (PA09)
/MOSI: J4.4, U2.13 (PA10)
/NEOPIX: D1.4 (DIN), U2.19 (PA18)
/NEO_PWR: D1.3 (VDD), U2.16 (PA15)
/RX_A7: J4.7, U2.8 (PA07)
/SCK: J4.6, U2.14 (PA11)
/SCL: J2.6, U2.18 (PA17)
/SDA: J2.5, U2.17 (PA16)
/SWCLK: J1.9, U2.31 (PA30/SWCLK); also elsewhere on the board
/SWDIO: J1.10, U2.32 (PA31/SWDIO); also elsewhere on the board
/TX_A6: J2.7, U2.7 (PA06)
/~RESET: J1.6, R1.2, RESET1.1, RESET1.2, U2.26 (~RESET); also elsewhere on the board
GND: C1.2, C2.2, C3.2, C4.2, C5.2, C6.2, D1.2 (GND), J1.2, J1.3, J1.5, J3.5 (GND), J3.6 (Shield), J4.2, RESET1.3, RESET1.4, U1.2 (GND), U2.10 (GND), U2.28 (GNDA), U3.2 (GND); also elsewhere on the board
unnamed: C4.1, U2.29 (VDDCORE)
unnamed: D2.2 (A), J3.1 (VBUS)

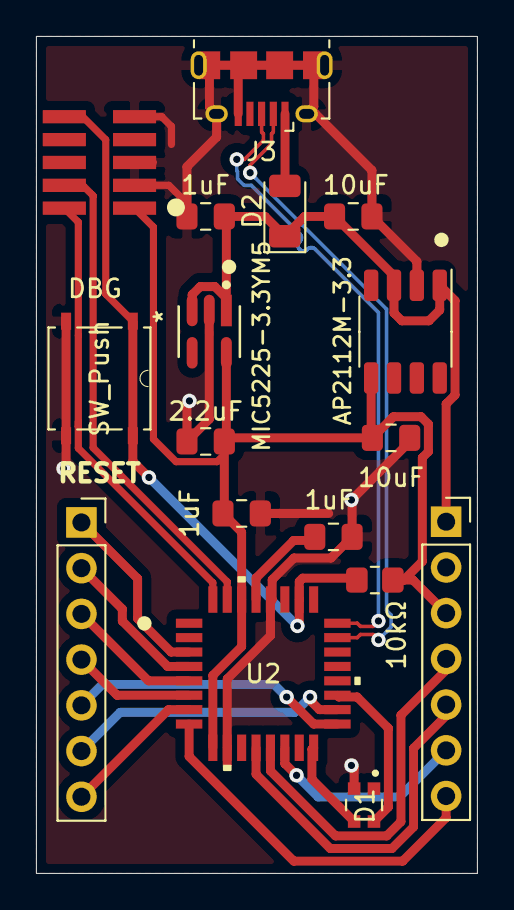
[picture p20: board MinimalSAMD21.kicad_pcb from above]

Board: 2 copper layers, 24.5 x 46.5 mm, 17 parts (0 on the bottom side), 23 nets.

Other parts of the board:
DBG: DEBUG; CNC_3220-10-0300-00_SWD_Receptacle

Their connections:
+3V3: DBG.1; also elsewhere on the board
/SWCLK: DBG.9; also elsewhere on the board
/SWDIO: DBG.10; also elsewhere on the board
/~RESET: DBG.6; also elsewhere on the board
GND: DBG.2, DBG.3, DBG.5; also elsewhere on the board
