jspolsky/blinky/pcbs/ledtrix/ledtrix.kicad_pcb

## KiCad design pcbs/ledtrix/ledtrix.kicad_pcb (2021-12-27)

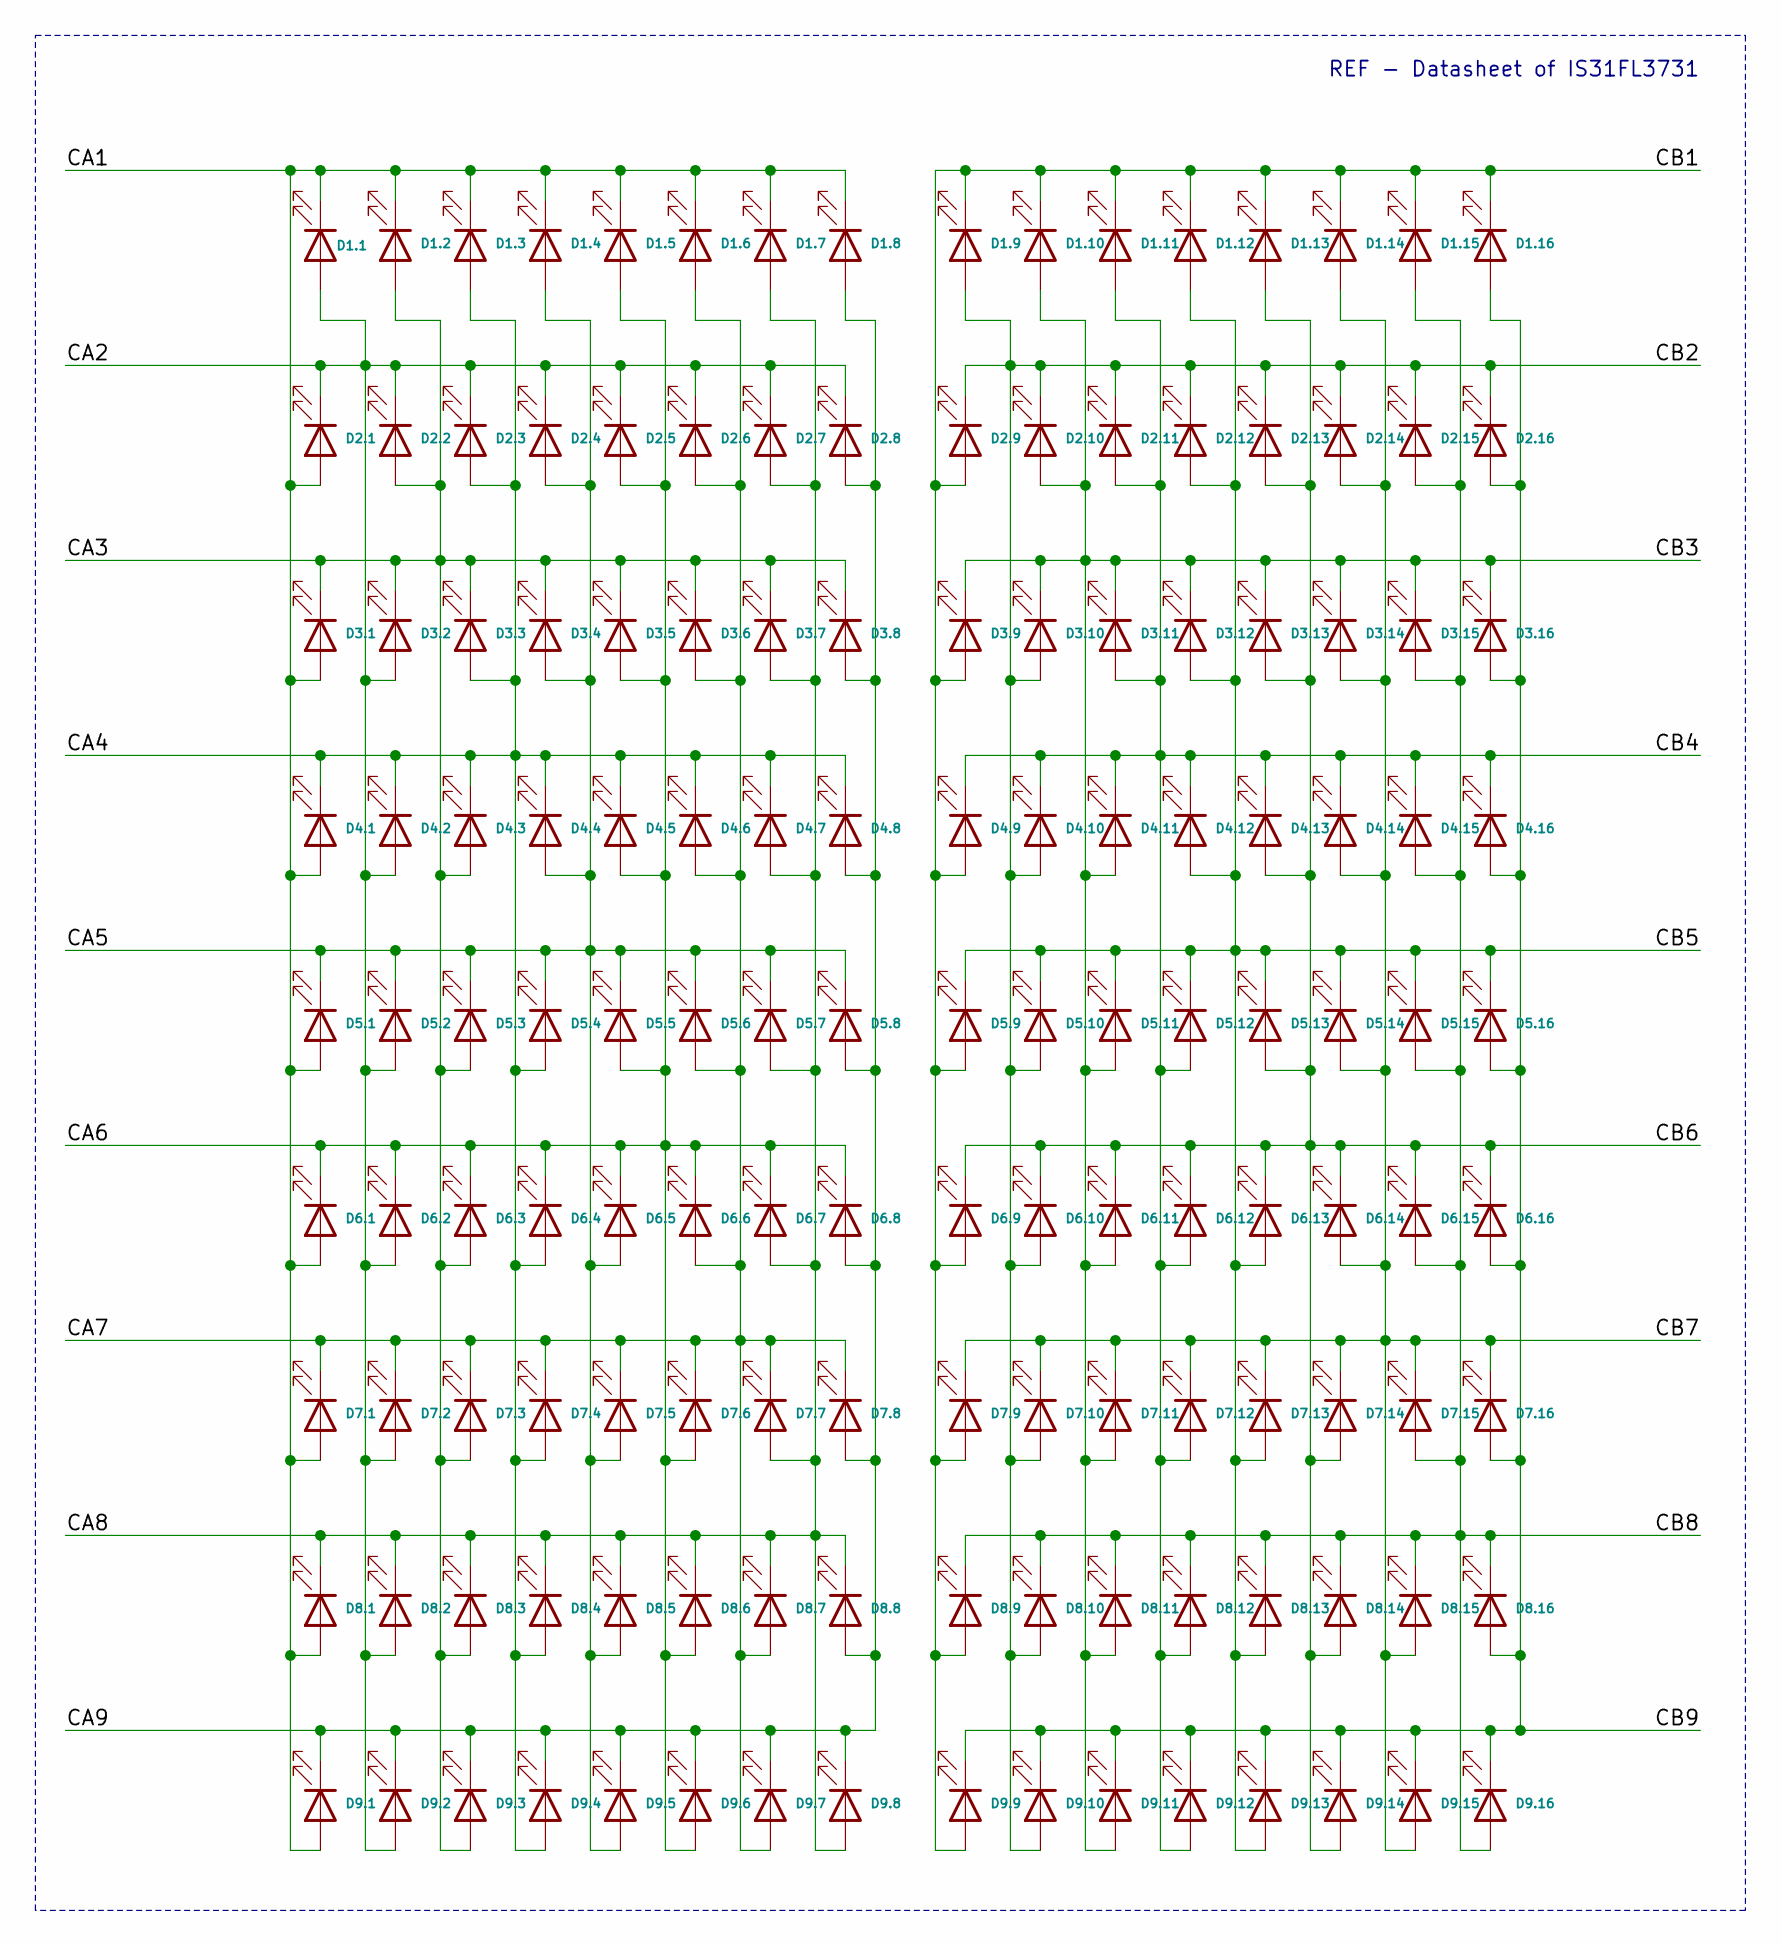
[picture p21: schematic ledtrix for blinky.sch]

Parts:
D1.1, D1.2, D1.3, D1.4, D1.5, D1.6, D1.7, D1.8, D1.9, D1.10, D1.11, D1.12, D1.13, D1.14, D1.15, D1.16, D2.1, D2.2, D2.3, D2.4, D2.5, D2.6, D2.7, D2.8, D2.9, D2.10, D2.11, D2.12, D2.13, D2.14, D2.15, D2.16, D3.1, D3.2, D3.3, D3.4, D3.5, D3.6, D3.7, D3.8, D3.9, D3.10, D3.11, D3.12, D3.13, D3.14, D3.15, D3.16, D4.1, D4.2, D4.3, D4.4, D4.5, D4.6, D4.7, D4.8, D4.9, D4.10, D4.11, D4.12, D4.13, D4.14, D4.15, D4.16, D5.1, D5.2, D5.3, D5.4, D5.5, D5.6, D5.7, D5.8, D5.9, D5.10, D5.11, D5.12, D5.13, D5.14, D5.15, D5.16, D6.1, D6.2, D6.3, D6.4, D6.5, D6.6, D6.7, D6.8, D6.9, D6.10, D6.11, D6.12, D6.13, D6.14, D6.15, D6.16, D7.1, D7.2, D7.3, D7.4, D7.5, D7.6, D7.7, D7.8, D7.9, D7.10, D7.11, D7.12, D7.13, D7.14, D7.15, D7.16, D8.1, D8.2, D8.3, D8.4, D8.5, D8.6, D8.7, D8.8, D8.9, D8.10, D8.11, D8.12, D8.13, D8.14, D8.15, D8.16, D9.1, D9.2, D9.3, D9.4, D9.5, D9.6, D9.7, D9.8, D9.9, D9.10, D9.11, D9.12, D9.13, D9.14, D9.15, D9.16: LED; LED_0603_For_Blinky

Connections:
/CA1: D1.1.1 (K), D1.2.1 (K), D1.3.1 (K), D1.4.1 (K), D1.5.1 (K), D1.6.1 (K), D1.7.1 (K), D1.8.1 (K), D2.1.2 (A), D3.1.2 (A), D4.1.2 (A), D5.1.2 (A), D6.1.2 (A), D7.1.2 (A), D8.1.2 (A), D9.1.2 (A); also elsewhere on the board
/CA2: D1.1.2 (A), D2.1.1 (K), D2.2.1 (K), D2.3.1 (K), D2.4.1 (K), D2.5.1 (K), D2.6.1 (K), D2.7.1 (K), D2.8.1 (K), D3.2.2 (A), D4.2.2 (A), D5.2.2 (A), D6.2.2 (A), D7.2.2 (A), D8.2.2 (A), D9.2.2 (A); also elsewhere on the board
/CA3: D1.2.2 (A), D2.2.2 (A), D3.1.1 (K), D3.2.1 (K), D3.3.1 (K), D3.4.1 (K), D3.5.1 (K), D3.6.1 (K), D3.7.1 (K), D3.8.1 (K), D4.3.2 (A), D5.3.2 (A), D6.3.2 (A), D7.3.2 (A), D8.3.2 (A), D9.3.2 (A); also elsewhere on the board
/CA4: D1.3.2 (A), D2.3.2 (A), D3.3.2 (A), D4.1.1 (K), D4.2.1 (K), D4.3.1 (K), D4.4.1 (K), D4.5.1 (K), D4.6.1 (K), D4.7.1 (K), D4.8.1 (K), D5.4.2 (A), D6.4.2 (A), D7.4.2 (A), D8.4.2 (A), D9.4.2 (A); also elsewhere on the board
/CA5: D1.4.2 (A), D2.4.2 (A), D3.4.2 (A), D4.4.2 (A), D5.1.1 (K), D5.2.1 (K), D5.3.1 (K), D5.4.1 (K), D5.5.1 (K), D5.6.1 (K), D5.7.1 (K), D5.8.1 (K), D6.5.2 (A), D7.5.2 (A), D8.5.2 (A), D9.5.2 (A); also elsewhere on the board
/CA6: D1.5.2 (A), D2.5.2 (A), D3.5.2 (A), D4.5.2 (A), D5.5.2 (A), D6.1.1 (K), D6.2.1 (K), D6.3.1 (K), D6.4.1 (K), D6.5.1 (K), D6.6.1 (K), D6.7.1 (K), D6.8.1 (K), D7.6.2 (A), D8.6.2 (A), D9.6.2 (A); also elsewhere on the board
/CA7: D1.6.2 (A), D2.6.2 (A), D3.6.2 (A), D4.6.2 (A), D5.6.2 (A), D6.6.2 (A), D7.1.1 (K), D7.2.1 (K), D7.3.1 (K), D7.4.1 (K), D7.5.1 (K), D7.6.1 (K), D7.7.1 (K), D7.8.1 (K), D8.7.2 (A), D9.7.2 (A); also elsewhere on the board
/CA8: D1.7.2 (A), D2.7.2 (A), D3.7.2 (A), D4.7.2 (A), D5.7.2 (A), D6.7.2 (A), D7.7.2 (A), D8.1.1 (K), D8.2.1 (K), D8.3.1 (K), D8.4.1 (K), D8.5.1 (K), D8.6.1 (K), D8.7.1 (K), D8.8.1 (K), D9.8.2 (A); also elsewhere on the board
/CA9: D1.8.2 (A), D2.8.2 (A), D3.8.2 (A), D4.8.2 (A), D5.8.2 (A), D6.8.2 (A), D7.8.2 (A), D8.8.2 (A), D9.1.1 (K), D9.2.1 (K), D9.3.1 (K), D9.4.1 (K), D9.5.1 (K), D9.6.1 (K), D9.7.1 (K), D9.8.1 (K); also elsewhere on the board
/CB1: D1.9.1 (K), D1.10.1 (K), D1.11.1 (K), D1.12.1 (K), D1.13.1 (K), D1.14.1 (K), D1.15.1 (K), D1.16.1 (K), D2.9.2 (A), D3.9.2 (A), D4.9.2 (A), D5.9.2 (A), D6.9.2 (A), D7.9.2 (A), D8.9.2 (A), D9.9.2 (A); also elsewhere on the board
/CB2: D1.9.2 (A), D2.9.1 (K), D2.10.1 (K), D2.11.1 (K), D2.12.1 (K), D2.13.1 (K), D2.14.1 (K), D2.15.1 (K), D2.16.1 (K), D3.10.2 (A), D4.10.2 (A), D5.10.2 (A), D6.10.2 (A), D7.10.2 (A), D8.10.2 (A), D9.10.2 (A); also elsewhere on the board
/CB3: D1.10.2 (A), D2.10.2 (A), D3.9.1 (K), D3.10.1 (K), D3.11.1 (K), D3.12.1 (K), D3.13.1 (K), D3.14.1 (K), D3.15.1 (K), D3.16.1 (K), D4.11.2 (A), D5.11.2 (A), D6.11.2 (A), D7.11.2 (A), D8.11.2 (A), D9.11.2 (A); also elsewhere on the board
/CB4: D1.11.2 (A), D2.11.2 (A), D3.11.2 (A), D4.9.1 (K), D4.10.1 (K), D4.11.1 (K), D4.12.1 (K), D4.13.1 (K), D4.14.1 (K), D4.15.1 (K), D4.16.1 (K), D5.12.2 (A), D6.12.2 (A), D7.12.2 (A), D8.12.2 (A), D9.12.2 (A); also elsewhere on the board
/CB5: D1.12.2 (A), D2.12.2 (A), D3.12.2 (A), D4.12.2 (A), D5.9.1 (K), D5.10.1 (K), D5.11.1 (K), D5.12.1 (K), D5.13.1 (K), D5.14.1 (K), D5.15.1 (K), D5.16.1 (K), D6.13.2 (A), D7.13.2 (A), D8.13.2 (A), D9.13.2 (A); also elsewhere on the board
/CB6: D1.13.2 (A), D2.13.2 (A), D3.13.2 (A), D4.13.2 (A), D5.13.2 (A), D6.9.1 (K), D6.10.1 (K), D6.11.1 (K), D6.12.1 (K), D6.13.1 (K), D6.14.1 (K), D6.15.1 (K), D6.16.1 (K), D7.14.2 (A), D8.14.2 (A), D9.14.2 (A); also elsewhere on the board
/CB7: D1.14.2 (A), D2.14.2 (A), D3.14.2 (A), D4.14.2 (A), D5.14.2 (A), D6.14.2 (A), D7.9.1 (K), D7.10.1 (K), D7.11.1 (K), D7.12.1 (K), D7.13.1 (K), D7.14.1 (K), D7.15.1 (K), D7.16.1 (K), D8.15.2 (A), D9.15.2 (A); also elsewhere on the board
/CB8: D1.15.2 (A), D2.15.2 (A), D3.15.2 (A), D4.15.2 (A), D5.15.2 (A), D6.15.2 (A), D7.15.2 (A), D8.9.1 (K), D8.10.1 (K), D8.11.1 (K), D8.12.1 (K), D8.13.1 (K), D8.14.1 (K), D8.15.1 (K), D8.16.1 (K), D9.16.2 (A); also elsewhere on the board
/CB9: D1.16.2 (A), D2.16.2 (A), D3.16.2 (A), D4.16.2 (A), D5.16.2 (A), D6.16.2 (A), D7.16.2 (A), D8.16.2 (A), D9.9.1 (K), D9.10.1 (K), D9.11.1 (K), D9.12.1 (K), D9.13.1 (K), D9.14.1 (K), D9.15.1 (K), D9.16.1 (K); also elsewhere on the board

Notes on the sheet:
REF - Datasheet of IS31FL3731

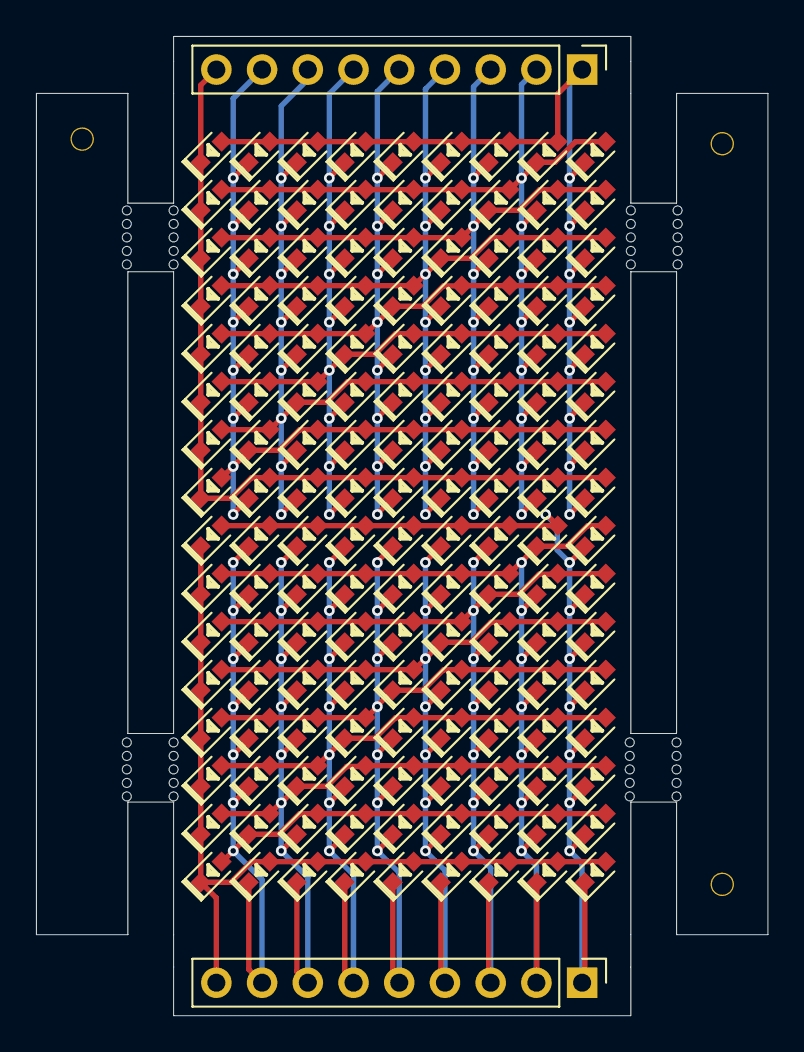
[picture p22: board ledtrix.kicad_pcb from above]

Board: 2 copper layers, 40.6 x 54.4 mm, 153 parts (0 on the bottom side), 18 nets.

Other parts of the board:
H1, H2, H4, H5: Mousebites; Mouse_Bite_For_Clipper
H7, H8, H9: MountingHole; JCLPCB_Tooling_Hole
J1, J2: Conn; PinHeader_1x09_P2.54mm_Vertical

Their connections:
/CA1: J1.1; also elsewhere on the board
/CA2: J1.2; also elsewhere on the board
/CA3: J1.3; also elsewhere on the board
/CA4: J1.4; also elsewhere on the board
/CA5: J1.5; also elsewhere on the board
/CA6: J1.6; also elsewhere on the board
/CA7: J1.7; also elsewhere on the board
/CA8: J1.8; also elsewhere on the board
/CA9: J1.9; also elsewhere on the board
/CB1: J2.1; also elsewhere on the board
/CB2: J2.2; also elsewhere on the board
/CB3: J2.3; also elsewhere on the board
/CB4: J2.4; also elsewhere on the board
/CB5: J2.5; also elsewhere on the board
/CB6: J2.6; also elsewhere on the board
/CB7: J2.7; also elsewhere on the board
/CB8: J2.8; also elsewhere on the board
/CB9: J2.9; also elsewhere on the board
