jspolsky/blinky/blinky (arm)/src/pins.h

#pragma once

#define BUTTON_PIN A0
#define IRRECEIVE_PIN A1
#define IRSEND_PIN A2
#define IRPOWER_PIN A3
#define MATRIX_ENABLE_PIN A6   /* aka TX */
#define RESET_INVENTORY_PIN A7 /* aka RX */
#define RANDOM_NOISE_PIN A8
