jspolsky/blinky/IRTest-SimpleSender/IRTest-SimpleSender.ino

// SIMPLE CODE FOR A GEMMA M0
// HOOKED UP TO AN IR LED on A2
//
// IT SENDS ALL COMMANDS, 0 - 255, EVERY
// 100 ms FOR TESTING, THUS UNLOCKING
// EVERY ANIMATION

/*
 * SimpleSender.cpp
 *
 *  Demonstrates sending IR codes in standard format with address and command
 *  An extended example for sending can be found as SendDemo.
 *
 *  Copyright (C) 2020-2021  Armin Joachimsmeyer
 *  armin.joachimsmeyer@gmail.com
 *
 *  This file is part of Arduino-IRremote https://github.com/Arduino-IRremote/Arduino-IRremote.
 *
 *  MIT License
 */
#include <Arduino.h>

/*
 * Define macros for input and output pin etc.
 */
#include "PinDefinitionsAndMore.h"

#define IR_SEND_PIN A2

//#define SEND_PWM_BY_TIMER
//#define USE_NO_SEND_PWM

#include <IRremote.h>

void setup()
{
    pinMode(LED_BUILTIN, OUTPUT);

    Serial.begin(115200);

    // Just to know which program is running on my Arduino
    Serial.println(F("START " __FILE__ " from " __DATE__ "\r\nUsing library version " VERSION_IRREMOTE));

    /*
     * The IR library setup. That's all!
     */
    IrSender.begin(IR_SEND_PIN, ENABLE_LED_FEEDBACK); // Specify send pin and enable feedback LED at default feedback LED pin

    Serial.print(F("Ready to send IR signals at pin "));
    Serial.println(IR_SEND_PIN);
}

/*
 * Set up the data to be sent.
 * For most protocols, the data is build up with a constant 8 (or 16 byte) address
 * and a variable 8 bit command.
 * There are exceptions like Sony and Denon, which have 5 bit address.
 */
uint16_t sAddress = 0xCFFE;
uint8_t sCommand = 0x00;
uint8_t sRepeats = 0;

void loop()
{

    int start = millis();

    /*
     * Print current send values
     */
    Serial.println();
    Serial.print(F("Send now: address=0x"));
    Serial.print(sAddress, HEX);
    Serial.print(F(" command=0x"));
    Serial.print(sCommand, HEX);
    Serial.print(F(" repeats="));
    Serial.print(sRepeats);
    Serial.println();

    Serial.println(F("Send NEC with 16 bit address"));
    Serial.flush();

    // Results for the first loop to: Protocol=NEC Address=0x102 Command=0x34 Raw-Data=0xCB340102 (32 bits)
    IrSender.sendNEC(sAddress, sCommand, sRepeats);

    //    Serial.println(F("Send NECRaw 0xCB340102"));
    //    IrSender.sendNECRaw(0xCB340102, sRepeats);

    sCommand++; // wraps at 255

    int finish = millis();
    Serial.print("elapsed time = ");
    Serial.println(finish - start);

    delay(100 - (finish - start)); // delay must be greater than 5 ms (RECORD_GAP_MICROS), otherwise the receiver sees it as one long signal
}
