jspolsky/blinky/parsepng/test.cpp

const uint8_t a[] = {
	____, ____, ____, ____, ____, ____, ____, ____, ____, 
	____, ____, ____, ____, ____, ____, ____, ____, ____, 
	____, ____, ____, ____, ____, ____, ____, ____, ____, 
	____, ____, ____, ____, ____, ____, ____, ____, ____, 
	____, ____, ____, ____, ____, ____, ____, ____, ____, 
	____, ____, ____, ____, ____, ____, ____, ____, ____, 
	____, ____, ____, ____, ____, ____, ____, ____, ____, 
	____, ____, ____, ____, ____, ____, ____, ____, ____, 
	____, ____, ____, ____, ____, ____, ____, ____, ____, 
	____, ____, ____, ____, ____, 0x03, 0x07, 0x02, ____, 
	____, ____, 0x4d, 0x4d, ____, 0x07, 0x4f, 0x3b, ____, 
	____, 0x4d, 0x61, 0x4d, 0x4d, 0x4d, 0x3c, 0x3b, 0x2d, 
	____, 0x4d, 0x4d, 0x4d, 0x4d, 0x3a, 0x3a, 0x2d, 0x20, 
	____, ____, 0x4d, 0x4d, 0x3a, 0x3a, 0x2d, 0x20, ____, 
	____, ____, ____, 0x3a, 0x3a, 0x2d, 0x20, ____, ____, 
	____, ____, ____, ____, 0x2d, 0x20, ____, ____, ____, 

	____, ____, ____, ____, ____, ____, ____, ____, ____, 
	____, ____, ____, ____, ____, ____, ____, ____, ____, 
	____, ____, ____, ____, ____, ____, ____, ____, ____, 
	____, ____, ____, ____, ____, ____, ____, ____, ____, 
	____, ____, ____, ____, ____, ____, ____, ____, ____, 
	____, ____, ____, ____, ____, ____, ____, ____, ____, 
	____, ____, ____, ____, ____, 0x05, 0x0b, 0x04, ____, 
	____, ____, 0x7a, 0x7a, ____, 0x0c, 0x7c, 0x5e, ____, 
	____, 0x7a, 0x99, 0x7a, 0x7a, 0x7a, 0x5e, 0x5d, 0x47, 
	____, 0x7a, 0x7a, 0x7a, 0x7a, 0x5c, 0x5c, 0x47, 0x33, 
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
	____, 0xff, 0xff, 0xff, 0xff, 0xff, 0xff, 0xff, 0xe4, 
	____, 0xff, 0xff, 0xff, 0xff, 0xff, 0xff, 0xe4, 0xa3, 
	____, ____, 0xff, 0xff, 0xff, 0xff, 0xe4, 0xa3, ____, 
	____, ____, ____, 0xff, 0xff, 0xe4, 0xa3, ____, ____, 
	____, ____, ____, ____, 0xe4, 0xa3, ____, ____, ____, 

};
