jspolsky/blinky/blinky (esp32-idf)/main/matrix.h

#pragma once

namespace matrix
{
    void setup();
    void displayAnimation(uint16_t animationNumber, bool fAtPowerOn = false);
    void powerOff();

    const uint8_t ISSI_COMMANDREGISTER = 0xFD;
    const uint8_t ISSI_BANK_FUNCTIONREG = 0x0B;
    const uint8_t ISSI_REG_SHUTDOWN = 0x0A;
    const uint8_t ISSI_REG_CONFIG = 0x00;
    const uint8_t ISSI_REG_CONFIG_PICTUREMODE = 0x00;
    const uint8_t ISSI_REG_CONFIG_AUTOPLAYMODE = 0x08;
    const uint8_t ISSI_REG_PICTUREFRAME = 0x01;
    const uint8_t ISSI_REG_AUDIOSYNC = 0x06;
    const uint8_t ISSI_REG_AUTOPLAY_WAY_OF_DISPLAY = 0x02;
    const uint8_t ISSI_REG_AUTOPLAY_DELAY_TIME = 0x03;
}
