jspolsky/blinky/blinky (esp32-idf)/main/inventory.h

#pragma once

namespace inventory
{
    void setup();

    // returns the animation that permanently belongs
    // to this device
    uint16_t getMyAnimation();

    // returns the animation that is currently showing
    uint16_t getCurrentAnimation();

    // returns the next animation that we also own,
    // round-robin
    uint16_t nextAnimation();

    // receives an animation from a friend and adds
    // it to the inventory of animations we own
    //
    uint16_t addToInventory(uint16_t);

}
