jspolsky/blinky/(commit log)

2021-10-11 Switch to ArduinoLowPower library. Add button.
2021-10-11 working button press with and without wakeup
2021-10-11 turn off status LED while measuring batt life
2021-10-12 wakes up on IR receive! (Doesn't go back to sleep ever)
    [blinky.cpp]
2021-10-12 Starting to modularize. Ledmatrix.
2021-10-13 Button code moved out
2021-10-13 ready to control power to IR receiver from a pin
2021-10-13 Not going to use MCU to blink the ir receiver, it's too power consumptive
2021-10-14 Button "click" is working with debounce
2021-10-14 All the button logic is sorted out!
2021-11-03 IR debugging device (receive only)
2021-11-03 pin for IR sending
2021-11-03 IR receiver no longer runs nonstop
    [irreceive.cpp, main.cpp]
2021-11-03 button control pass through to IR
2021-11-04 onboard neopixel is for button state debugging
2021-11-04 power off ir receiver when not in use
2021-11-05 keep going after button lifted; always end protocol after 30s
2021-11-10 parsepng improved to handle different number of frames
2021-11-10 tweaking the greyscale / gamma correction
    [matrix.cpp]
2021-11-10 flip 9x16 to 16x9 in the .h file so we can pack two pixels in a byte later
    [matrix.cpp, parsepng.js]
2021-11-11 short click now actually changes animation
    [inventory.cpp, inventory.h, main.cpp]
2021-11-11 slight cleanups to better interpret button clicks
2021-11-11 go back to current animation when done
2021-11-11 Some tweaking of button logic for fewer confused clicks
2021-11-11 show greyscales - for debugging power consumption
2021-11-12 full swap is working
    [inventory.cpp, ir.cpp]
2021-11-21 man stick legs
2021-11-23 we have a bom (but it's in google)
2021-11-23 added ben's animation
    [MinimalSAMD21-B_Cu.gbr, MinimalSAMD21-B_Mask.gbr, MinimalSAMD21-B_Paste.gbr, MinimalSAMD21-B_SilkS.gbr, MinimalSAMD21-Edge_Cuts.gbr, MinimalSAMD21-F_Cu.gbr, MinimalSAMD21-F_Mask.gbr, MinimalSAMD21-F_Paste.gbr]
2021-11-23 Using RTC for PowerSave - scaffold
2021-11-23 PowerSave at 2 hrs implemented! Needs more test
2021-11-27 Schematic and PCB design - 90%
    [blinky.kicad_pcb, blinky.sch]
2021-12-01 blinky version 1 PCB design is done!
    [blinky.kicad_pcb, blinky.sch]
2021-12-01 this version was submitted to pcbway
    [blinky-B_Cu.gbr, blinky-B_Fab.gbr, blinky-B_Mask.gbr, blinky-B_Paste.gbr, blinky-B_SilkS.gbr, blinky-Eco1_User.gbr, blinky-Edge_Cuts.gbr, blinky-F_Cu.gbr]
2021-12-06 Gerbers for first prototype production
    [blinky-B_Cu.gbr, blinky-B_Fab.gbr, blinky-B_Mask.gbr, blinky-B_Paste.gbr, blinky-B_SilkS.gbr, blinky-Eco1_User.gbr, blinky-Edge_Cuts.gbr, blinky-F_Cu.gbr]
2021-12-10 simple test code to get minimal samd board working
2021-12-10 new design for minimal SAMD21 board
    [MinimalSAMD21-B_Cu.gbr, MinimalSAMD21-B_Mask.gbr, MinimalSAMD21-B_Paste.gbr, MinimalSAMD21-B_SilkS.gbr, MinimalSAMD21-Edge_Cuts.gbr, MinimalSAMD21-F_Cu.gbr, MinimalSAMD21-F_Mask.gbr, MinimalSAMD21-F_Paste.gbr]
2021-12-18 experimenting with turtle shaped PCB
    [R14_Outline.dxf]
2021-12-18 my own ESP32C3 development board
    [ClonedESP32DevBoard-B_Cu.gbr, ClonedESP32DevBoard-B_Mask.gbr, ClonedESP32DevBoard-B_Paste.gbr, ClonedESP32DevBoard-B_SilkS.gbr, ClonedESP32DevBoard-Edge_Cuts.gbr, ClonedESP32DevBoard-F_Cu.gbr, ClonedESP32DevBoard-F_Mask.gbr, ClonedESP32DevBoard-F_Paste.gbr]
2021-12-18 my own Charlieplex board
    [charlieplexboard-B_Cu.gbr, charlieplexboard-B_Mask.gbr, charlieplexboard-B_Paste.gbr, charlieplexboard-B_SilkS.gbr, charlieplexboard-Edge_Cuts.gbr, charlieplexboard-F_Cu.gbr, charlieplexboard-F_Mask.gbr, charlieplexboard-F_Paste.gbr]
2021-12-18 moved blinky to blinky (arm) and starting to rewrite for esp32c3
2021-12-18 the file structure I like works in Arduino IDE
2021-12-18 Button operation working (without sleep mode)
2021-12-18 added a pull-up resistor so deep sleep uses less power
2021-12-18 press button to wake up from deep sleep
2021-12-19 esp32 in arduino IDE experiment
2021-12-19 Handy ESP32-C3-DevKitM-1 tester
2021-12-19 Deep sleep; pin 2 wakeup! it's fast!!
2021-12-19 beginning of button logic
2021-12-19 short and long press logic
    [button.cpp]
2021-12-20 just move my button off of the strapping pin why i don't know
2021-12-20 implemented a little function to write things to i2c.
2021-12-21 fixed so it works at power up
    [IRTest-SimpleReceiver.ino]
2021-12-22 remember current animation and inventory on wakeup from deep sleep
2021-12-23 structure around exchange button
2021-12-23 inventory reset button! press it while booting up
2021-12-24 don't need to display animations on a thread anymore
2021-12-24 Revert "a lot of charlieplex initialization wasn't doing anything at all"
    This reverts commit d0891acefc49ccd1926b55f96ddce0c56e2a193e.
    [matrix.cpp]
2021-12-24 don't initialize charlieplex after first power up
2021-12-24 Power off IR receiver when not in use, power off screen too
2021-12-24 power off screen after 2 hours
2021-12-26 why is kicad so annoying
    [ClonedESP32DevBoard.sch]
2021-12-27 getting ARM working again
2021-12-27 LED-only PCB situation
    [ledtrix.kicad_pcb, ledtrix.sch]
2021-12-27 Make some boards with just the LEDs
    [bom.xlsx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]
2021-12-27 Updated blinky schematic (ARM) for latest technology
    [blinky.kicad_pcb, blinky.sch]
2021-12-27 started work on the pcb
    [blinky.kicad_pcb]
2021-12-28 routing this board here
    [blinky.kicad_pcb, blinky.sch, ledtrix for blinky.sch]
2021-12-28 making good progress on the circuit board
    [blinky.kicad_pcb, blinky.sch]
2021-12-29 Everything is done except artistic stuff
    [blinky.kicad_pcb]
2021-12-30 Moved power switch up to make board shorter
    [blinky.kicad_pcb]
2021-12-30 some 3d models
    [blinky.kicad_pcb]
2021-12-30 Put all the passive values on silkscreen
    [blinky.kicad_pcb]
2021-12-30 route sda/scl across the middle
    [blinky.kicad_pcb]
2021-12-30 tidied up a bit more routing to make board smaller
    [blinky.kicad_pcb]
2021-12-30 lots of beautiful decorations
    [blinky.kicad_pcb, experiment.dxf, piece1-4.dxf, piece1.dxf, turtle.dxf]
2021-12-30 mousebite improvements
    [blinky.kicad_pcb, blinky.sch]
2021-12-31 lovely logo
    [blinky.kicad_pcb, blinky.sch]
2021-12-31 more details
    [blinky.kicad_pcb, blinky.sch]
2021-12-31 ok, well that has been sent to china
    [blinky-B_Cu.gbr, blinky-B_Fab.gbr, blinky-B_Mask.gbr, blinky-B_Paste.gbr, blinky-B_SilkS.gbr, blinky-Eco1_User.gbr, blinky-Edge_Cuts.gbr, blinky-F_Cu.gbr]
2022-01-01 clean sample code showing new power management scheme
2022-01-01 new power management code perfected
2022-01-01 Hold A7 low at startup to reset inventory
    [inventory.cpp, pins.h]
2022-01-02 test pattern on animation reset
    [inventory.cpp, main.cpp, matrix.cpp, matrix.h]
2022-01-02 rewritten low power logic! clean!
2022-01-02 slightly shorter protocol to save power
    [ir.cpp]
2022-01-02 correct recovery after power up
    [matrix.cpp]
2022-01-03 generated a 3D file for PCB
2022-01-03 Use 100K resistor for Rext to save power
    [blinky.kicad_pcb, blinky.sch]
2022-01-04 renamed a folder to avoid confusion
    [animations.cpp, animations.h, button.cpp, inventory.cpp, inventory.h, ir.cpp]
2022-01-04 fixed a little off by one bug
    [parsepng.js]
2022-01-04 initial errors sending to serial -> fixed!
    [parsepng.js]
2022-01-05 don't need to generate .bin files any more, that was for esp32
2022-01-06 save a ton of power
2022-01-07 new protocol seems to save about 2.5-5 mA?
2022-01-07 lower power usage waiting on button
2022-02-21 Updated schematics and PCB to fix all known bugs
    [blinky.kicad_pcb, blinky.sch]
